sparkfun/SparkFun_Digi_XBee_Arduino_Shield-USB-C/docs/README.md

SparkFun Digi XBee® Development Arduino Shield (Qwiic)
========================================

SparkFun Digi XBee® Development Arduino Shield (Qwiic) (https://www.sparkfun.com/products/22131)

[*SparkFun Digi XBee® Development Arduino Shield (Qwiic) (22131)*](https://www.sparkfun.com/products/22131)

The Sparkfun Digi XBee® Arduino Shield is your gateway to a world of wireless innovation on your favorite Arduino device. This shield integrates Digi's cutting-edge XBee 3 Low-Power LTE-M/NB-IoT and Digi XBee RR Pro modules (or any existing through-hole Digi XBee module) with your trusty Arduino, empowering you to build wireless projects that reach further and do more than ever. Whether you're a seasoned developer or a curious beginner, the SparkFun Digi XBee® Arduino Shield - USB-C (Qwiic) empowers you to bring your wildest IoT ideas to life.

It breaks out the functionality of your XBee module and adds the ability to connect to the cellular network and GNSS. This shield includes a USB-C connector, a Qwiic connector for all those lovely I<sup>2</sup>C sensors, as well as a Reset button and a user-defined D0 button, the ability to power your board from the R3/R4 board, and UART selection. 

Repository Contents
-------------------

* **/Documents** - Data sheets, additional product information
* **/Hardware** - Eagle design files (.brd, .sch)
* **/Production** - Production panel files (.brd)
* **/docs** - Files related to the hookup guide

Documentation
--------------
* **[Hookup Guide](http://docs.sparkfun.com/SparkFun_Digi_XBee3_Arduino_Shield)** - Basic hookup guide for the SparkFun Digi XBee® Development Arduino Shield (Qwiic).

License Information
-------------------

This product is _**open source**_! 

Please review the LICENSE.md file for license information. 

If you have any questions or concerns on licensing, please contact technical support on our [SparkFun forums](https://forum.sparkfun.com/viewforum.php?f=152).

Distributed as-is; no warranty is given.

- Your friends at SparkFun.

_<COLLABORATION CREDIT>_
