sparkfun/SparkFun_Digi_XBee_Arduino_Shield-USB-C/docs/introduction.md

---
icon: material/book-open-page-variant
---

<div class="grid cards desc" markdown>

-    <a href="https://www.sparkfun.com/products/22131">
    **SparkFun Digi XBee® Development Arduino Shield (Qwiic)**<br>
    **SKU:** WRL-22131

    ---

    <figure markdown>
    Product Thumbnail
    </figure></a>
    
-    The Sparkfun Digi XBee® Arduino Shield is your gateway to a world of wireless innovation on your favorite Arduino device. This shield integrates Digi's cutting-edge XBee 3 Low-Power LTE-M/NB-IoT and Digi XBee RR Pro modules (or any existing through-hole Digi XBee module) with your trusty Arduino, empowering you to build wireless projects that reach further and do more than ever. Whether you're a seasoned developer or a curious beginner, the SparkFun Digi XBee® Arduino Shield - USB-C (Qwiic) empowers you to bring your wildest IoT ideas to life. It breaks out the functionality of your XBee module and adds the ability to connect to the cellular network and GNSS. This shield includes a USB-C connector, a Qwiic connector for all those lovely I<sup>2</sup>C sensors, as well as a Reset button and a user-defined D0 button, the ability to power your board from the R3/R4 board, and UART selection. 

    <center>
    [Purchase from SparkFun :fontawesome-solid-cart-plus:{ .heart }](https://www.sparkfun.com/products/22131){ .md-button .md-button--primary }
    </center>

</div>

## Required Materials
To get started, users will need a few items. Now some users may already have a few of these items, feel free to modify your cart accordingly.

<div class="grid cards" markdown>

-   <a href="https://www.sparkfun.com/products/22131">
    <figure markdown>
    Product Thumbnail
    </figure>

    ---

    **SparkFun Digi XBee® Development Arduino Shield (Qwiic)**<br>
    WRL-22131</a>

-   <a href="https://www.sparkfun.com/products/22329">
    <figure markdown>
    Product Thumbnail
    </figure>

    ---

    **Digi XBee 3 Low-Power LTE-M/NB-IoT, GNSS, no SIM**<br>
    WRL-22329</a>

-   <a href="https://www.sparkfun.com/products/14743">
    <figure markdown>
    Product Thumbnail
    </figure>

    ---

    **USB 3.1 Cable A to C - 3 Foot**<br>
    CAB-14743</a>

</div>

## Suggested Reading

As a more professionally oriented product, we will skip over the more fundamental tutorials (i.e. [**Ohm's Law**](https://learn.sparkfun.com/tutorials/voltage-current-resistance-and-ohms-law) and [**What is Electricity?**](https://learn.sparkfun.com/tutorials/what-is-electricity)). However, below are a few tutorials that may help users familiarize themselves with various aspects of the board.

<div class="grid cards hide col-4" markdown align="center">

-   <a href="https://learn.sparkfun.com/tutorials/how-to-solder-through-hole-soldering">
    <figure markdown>
    How to Solder: Through-Hole Soldering
    </figure>
    </a>
    <a href="https://learn.sparkfun.com/tutorials/how-to-solder-through-hole-soldering">**How to Solder: Through-Hole Soldering**
    </a>

-   <a href="https://learn.sparkfun.com/tutorials/sparkfun-serial-basic-ch340c-hookup-guide">
    <figure markdown>
    SparkFun Serial Basic CH340C Hookup Guide
    </figure>
    </a>
    <a href="https://learn.sparkfun.com/tutorials/sparkfun-serial-basic-ch340c-hookup-guide">**SparkFun Serial Basic CH340C Hookup Guide**
    </a>    

-   <a href="https://learn.sparkfun.com/tutorials/82">
    <figure markdown>
    I2C
    </figure>
    </a>
    <a href="https://learn.sparkfun.com/tutorials/82">**I2C**
    </a>

-   <a href="https://learn.sparkfun.com/tutorials/analog-vs-digital">
    <figure markdown>
    Analog vs. Digital
    </figure>
    </a>
    <a href="https://learn.sparkfun.com/tutorials/analog-vs-digital">**Analog vs. Digital**
    </a>

-   <a href="https://learn.sparkfun.com/tutorials/serial-peripheral-interface-spi">
    <figure markdown>
    SPI
    </figure>
    </a>
    <a href="https://learn.sparkfun.com/tutorials/serial-peripheral-interface-spi">**SPI**
    </a>
</div>

<center>
<div align="center">
    <div style="top:5px;left:5px;background-color:Gray;position:relative">
        <div style="top:-5px;left:-5px;background-color:#ffffff;position:relative;border:1px solid black;">
            <a href="https://www.sparkfun.com/qwiic">Qwiic Connect System</a>
        </div>
    </div>
</div>
</center>

The Sparkfun Digi XBee® Arduino Shield takes advantage of the [Qwiic connect system](https://www.sparkfun.com/qwiic). We recommend familiarizing yourself with the **Logic Levels** and **I<sup>2</sup>C** tutorials.  Click on the banner above to learn more about [Qwiic products](https://www.sparkfun.com/qwiic).

<center>
    <iframe width="600" height="327" src="https://www.youtube.com/embed/x0RDEHqFIF8" title="SparkFun's Qwiic Connect System" frameborder="0" allow="accelerometer; autoplay; clipboard-write; encrypted-media; gyroscope; picture-in-picture" allowfullscreen></iframe>
</center>
