sparkfun/SparkFun_Digi_XBee_Arduino_Shield-USB-C/docs/resources_and_going_further.md

For more information related to the SparkFun Digi XBee® Arduino Shield, check out the resources below:

* [Product Page](https://www.sparkfun.com/products/22131){ target="_blank" }
* [Schematic](assets/board_files/22131_SparkFun_Digi_XBee_Arduino_Shield_Qwiic_Schematic.pdf){ target="_blank" }
* [Eagle Files](assets/board_files/SparkFun_Digi_XBee_Arduino_Shield_Qwiic_EagleFiles.zip){ target="_blank" }
* [Board Dimensions](assets/board_files/22131_SparkFun_Digi_XBee_Arduino_Shield_Qwiic_BoardOutline.png){ target="_blank" }
* [Hardware GitHub Respository](https://github.com/sparkfun/SparkFun_Digi_XBee_Arduino_Shield-USB-C){ target="_blank" }
* [Digi XBee® 3 Cat1 Smart Modem User Guide](assets/BoardFiles/XBee3_LTE_Cat_1-UserGuide-90002503-1.pdf){ target="_blank" }

Or check out other [Digi XBee Projects](https://learn.sparkfun.com/tutorials/tags/xbee) for inspiration:

<table style="border-style:none">
    <tr>
        <td style="vertical-align: text-top;" width="264px">
            <a href="https://www.sparkfun.com/news/3252">
            
            <h3 style="vertical-align: left">Be All That You Can XBee
            </h3></a>
        </td>
        <td style="vertical-align: text-top;" width="264px">
            <div style="text-align: center"><a href="https://www.sparkfun.com/news/2891">
            </div>
            <h3 style="text-align: left">Wireless RC Robot with Arduino and XBees
            </h3></a>
        </td>
        <td style="vertical-align: text-top;" width="264px">
            <div style="text-align: center"><a href="https://www.sparkfun.com/news/2761">
            </div>
            <h3 style="text-align: left">Enginursday: Prototype Capacitive Touch Dance Floor with a Teensy and XBees
            </h3></a>
        </td>
        <td style="vertical-align: text-top;" width="264px">
            <a href="https://www.sparkfun.com/news/2911">
            
            <h3 style="text-align: left">Wireless Gesture-Controlled Robot
            </h3></a>
        </td>
    </tr>
</table>
