sparkfun/SparkFun_Digi_XBee_Arduino_Shield-USB-C/docs/single_page.md

---
hide:
  - navigation
  - toc
icon: fontawesome/solid/scroll
---

# Introduction
--8<-- "./docs/introduction.md:5"

# Hardware Overview
--8<-- "./docs/hardware_overview.md:5"

# Hardware Assembly
--8<-- "./docs/hardware_assembly.md:5"

## Software Setup
--8<-- "./docs/software_setup_and_programming.md:5"

# Troubleshooting Tips
--8<-- "./docs/troubleshooting.md:5"

# Resources:
--8<-- "./docs/resources_and_going_further.md:5"
