sparkfun/SparkFun_Digi_XBee_Arduino_Shield-USB-C/docs/assets/img/22131-XBee_Dev_Arduino_Shield-USBCConnex.jpg

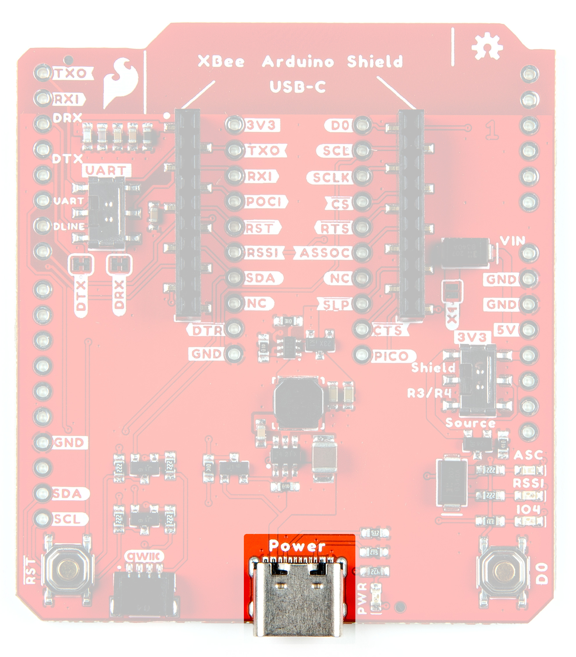
docs/assets/img/22131-XBee_Dev_Arduino_Shield-USBCConnex.jpg
