sparkfun/SparkFun_Digi_XBee_Arduino_Shield-USB-C/docs/hardware_assembly.md

---
icon: fontawesome/solid/screwdriver-wrench
---

Note the white silkscreen on the Shield PCB - this will help orient your Digi XBee as you're plugging it in. Make sure to match up the Digi XBee's two diagonal edges with the two diagonal lines on the PCB.

<figure markdown>
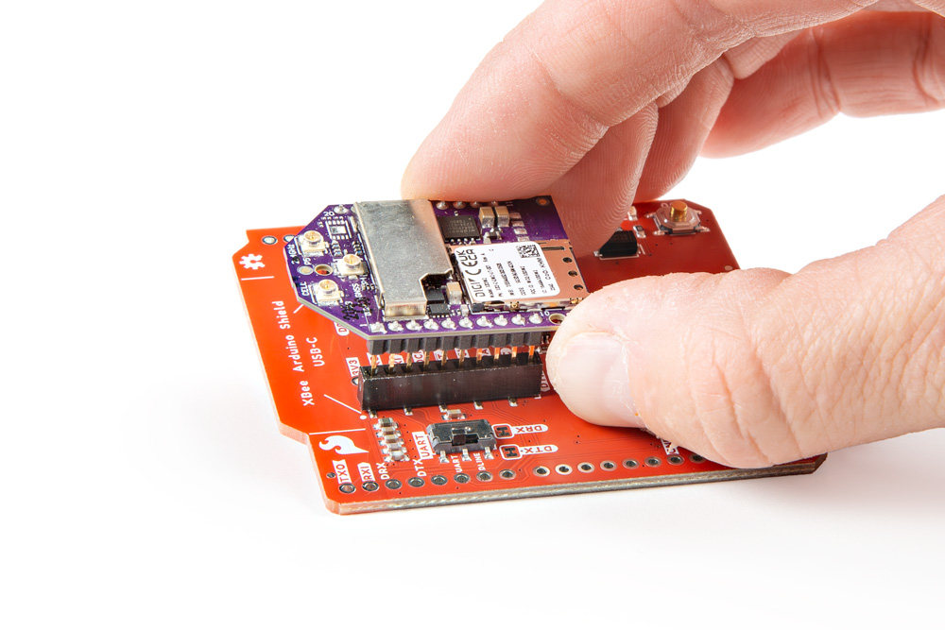
[picture p17: docs/assets/img/22131-Action-1.jpg]
Fitting the XBee into the Arduino Shield's Socket

<figcaption markdown>Fitting the Digi XBee into the Arduino Shield's Socket</figcaption>
</figure>
