sparkfun/SparkFun_Digi_XBee_Arduino_Shield-USB-C/Production/ordering_instructions.txt

panel size, 121x204mm
PCB thickness, 1.6mm
number of layers, 4
controlled impedance, JLC7628
soldermask color, Red
silkscreen color, White
oz copper, 1oz
finish, HASL lead free
stencils, top
pcs per panel, 6
min trace width, 0.2032mm / 0.0080in
min drill size, 0.3048mm / 0.0120in
filename to layer stackup 1/2/3/4: GTL, GL2, GL3, GBL
