sparkfun/SparkFun_Digi_XBee_Arduino_Shield-USB-C/docs/software_setup_and_programming.md

We have a number of tutorials detailing how to work with Digi XBees and their associated software. In particular, [XCTU](https://www.digi.com/products/embedded-systems/digi-xbee/digi-xbee-tools/xctu) is free software provided by Digi (the manufacturer of XBee), that provides a quick and easy way to configure and manage Digi XBees as well as test Digi XBee networks. 

If you haven't worked with XCTU before, head on over to our [Exploring XBees and XCTU tutorial](https://learn.sparkfun.com/tutorials/exploring-xbees-and-xctu/all#starting-with-x-ctu) to get set up.  

<center><table class="tg">
  <tr>
    <th class="tg-v0mg"><a href="https://learn.sparkfun.com/tutorials/exploring-xbees-and-xctu/all#starting-with-x-ctu">Exploring XBees and XCTU tutorial</a></th>
  </tr>
  <tr>
    <td class="tg-v0mg"><i>Exploring Digi XBees and XCTU tutorial</i></td>
  </tr>
</table>
</center>

You might also check out this [Digi XBee WiFi Hookup Guide](https://learn.sparkfun.com/tutorials/xbee-wifi-hookup-guide) if your project includes WiFi! 

<center>
<table class="tg">
  <tr>
    <th class="tg-v0mg"><a href="https://learn.sparkfun.com/tutorials/xbee-wifi-hookup-guide">XBee WiFi Hookup Guide</a></th>
  </tr>
  <tr>
    <td class="tg-v0mg"><i>XBee WiFi Hookup Guide</i></td>
  </tr>
</table>
</center>
