sparkfun/SparkFun_Digi_XBee_Arduino_Shield-USB-C/docs/troubleshooting.md

---
icon: fontawesome/solid/question
---

!!! note
    <span class="glyphicon glyphicon-question-sign" aria-hidden="true"></span>
        <strong> Not working as expected and need help? </strong> <br /><br />

    If you need technical assistance and more information on a product that is not working as you expected, we recommend heading on over to the <a href="https://www.sparkfun.com/technical_assistance">SparkFun Technical Assistance</a> page for some initial troubleshooting. <br /><br />

    <div style="text-align: center"><a href="https://www.sparkfun.com/technical_assistance" target="sfe_technical_assistance" class="md-button">SparkFun Technical Assistance Page</a></div>

    If you don't find what you need there, the <a href="https://forum.sparkfun.com/index.php">SparkFun Forums</a> are a great place to find and ask for help. If this is your first visit, you'll need to <a href="https://forum.sparkfun.com/ucp.php?mode=register">create a Forum Account</a> to search product forums and post questions.<br /><br />

    <div style="text-align: center"><a href="https://forum.sparkfun.com/ucp.php?mode=register" class="md-button">Create New Forum Account</a>&nbsp;&nbsp;&nbsp;<a href="https://forum.sparkfun.com/index.php" class="md-button md-button--primary">Log Into SparkFun Forums</a></div>
