sparkfun/SparkFun_Digi_XBee_Arduino_Shield-USB-C/docs/assets/board_files/22131_SparkFun_Digi_XBee_Arduino_Shield_Qwiic_Schematic.pdf

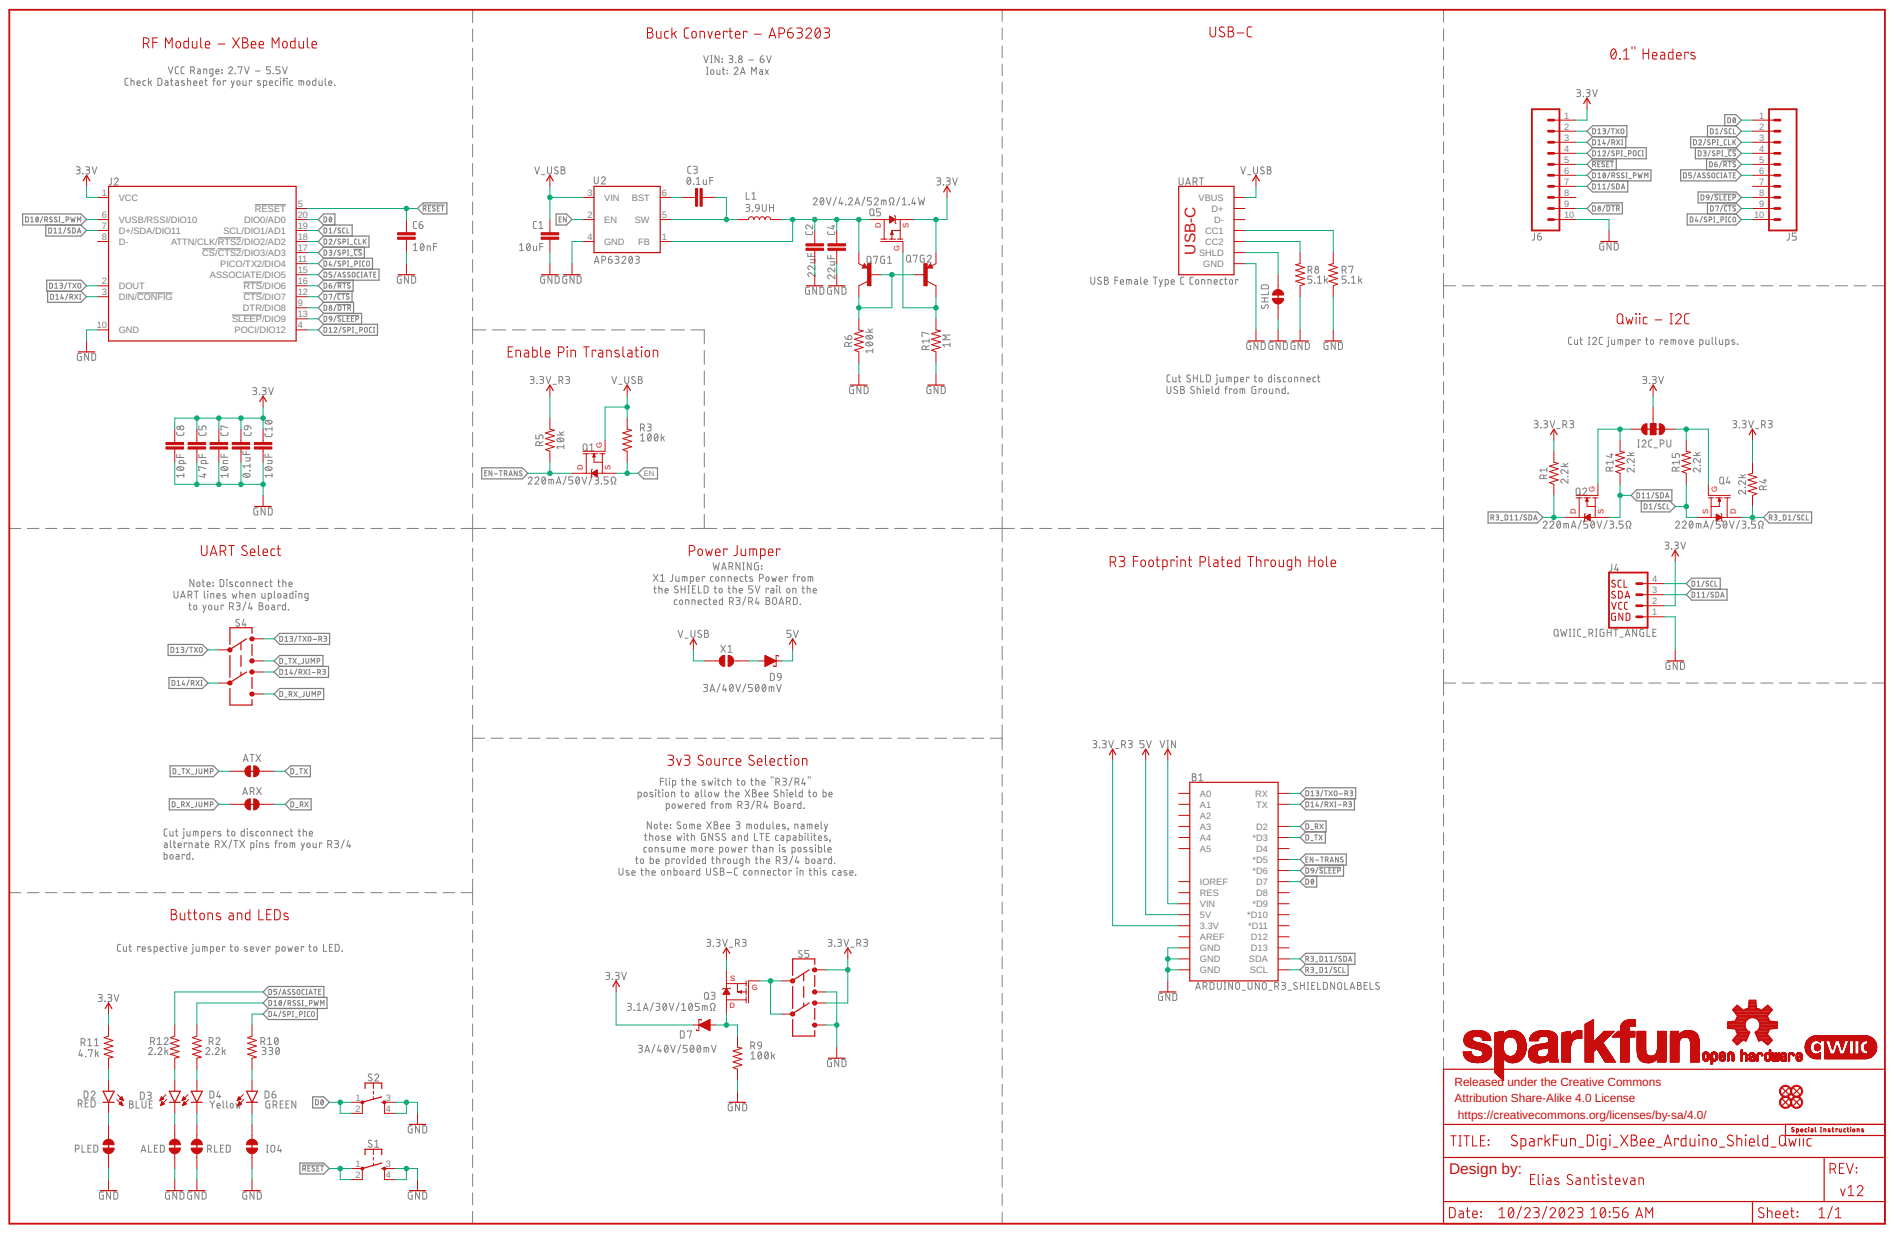
[picture p18: page 1]
