sparkfun/SparkFun_Digi_XBee_Arduino_Shield-USB-C/Hardware/SparkFun_Digi_XBee_Arduino_Shield_Qwiic.brd

## EAGLE design Hardware/SparkFun_Digi_XBee_Arduino_Shield_Qwiic.brd (2023-10-13)

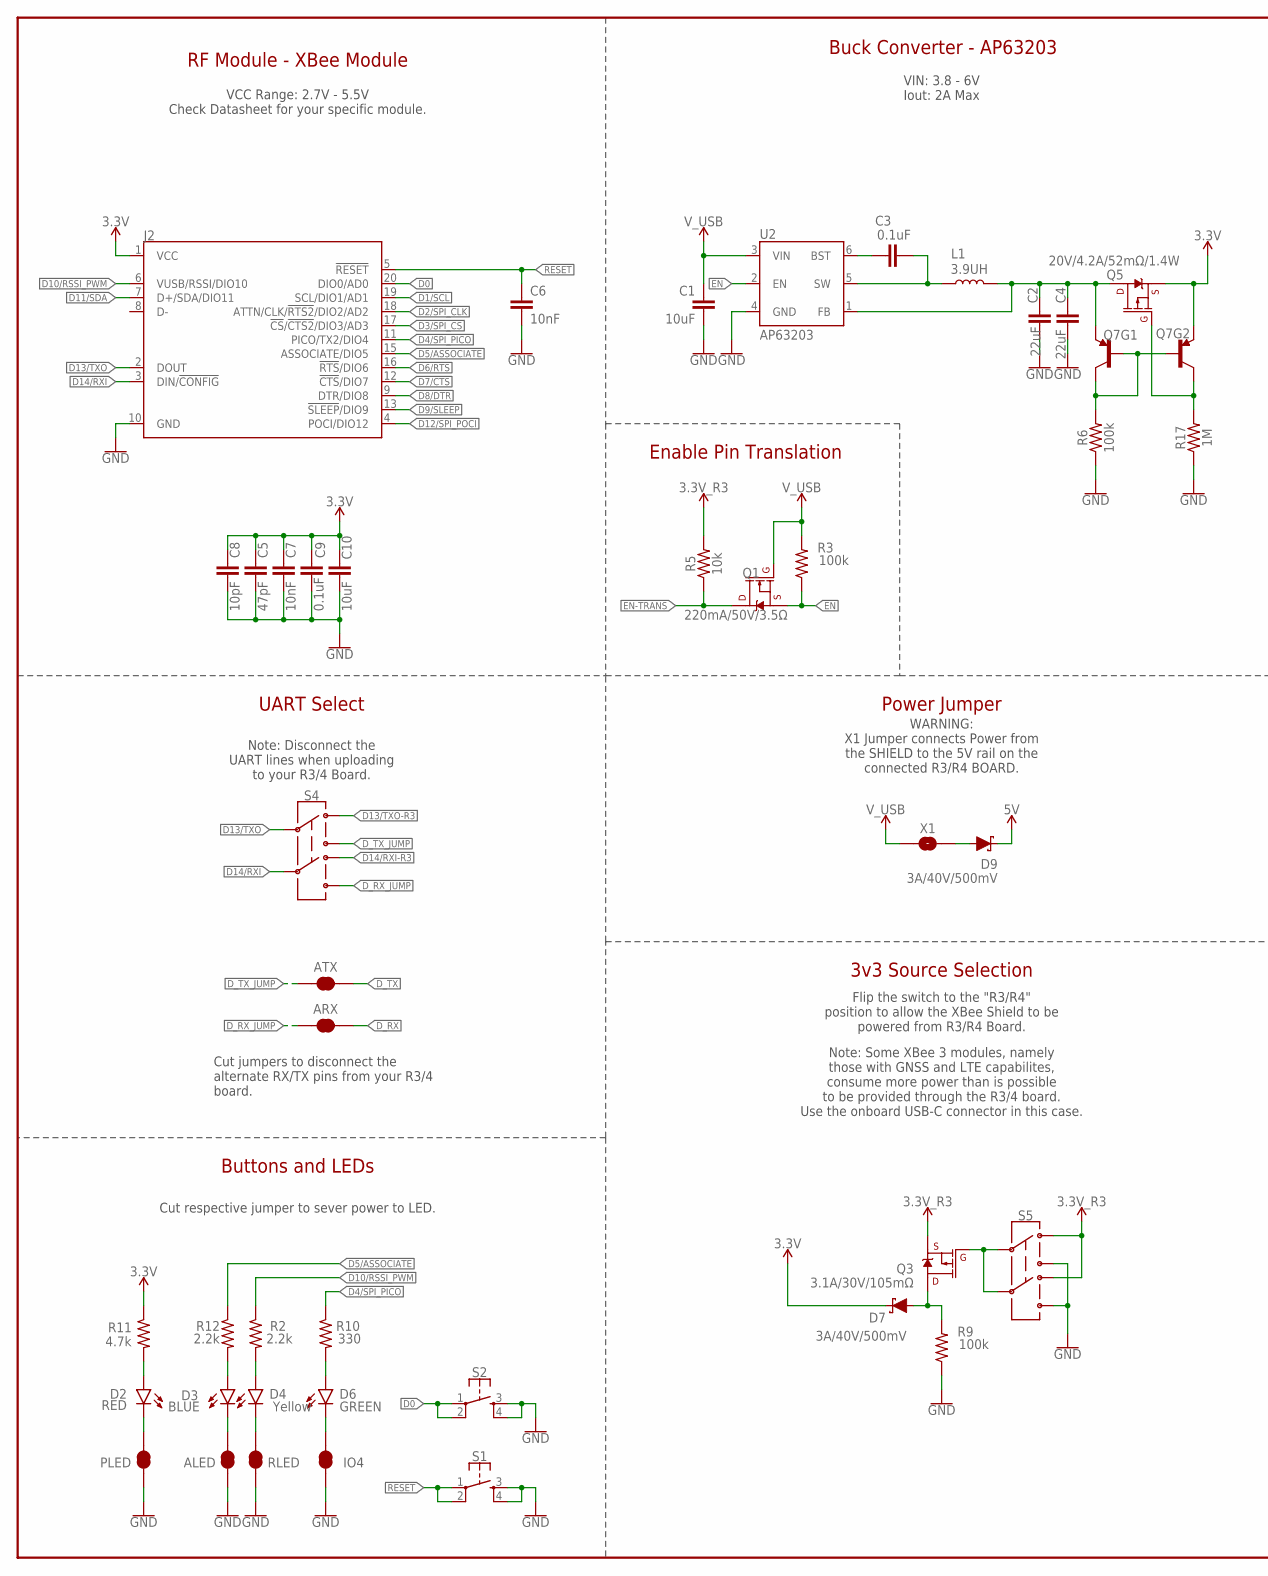
[picture p19: schematic SparkFun_Digi_XBee_Arduino_Shield_Qwiic.sch, part in row 1, column 1]

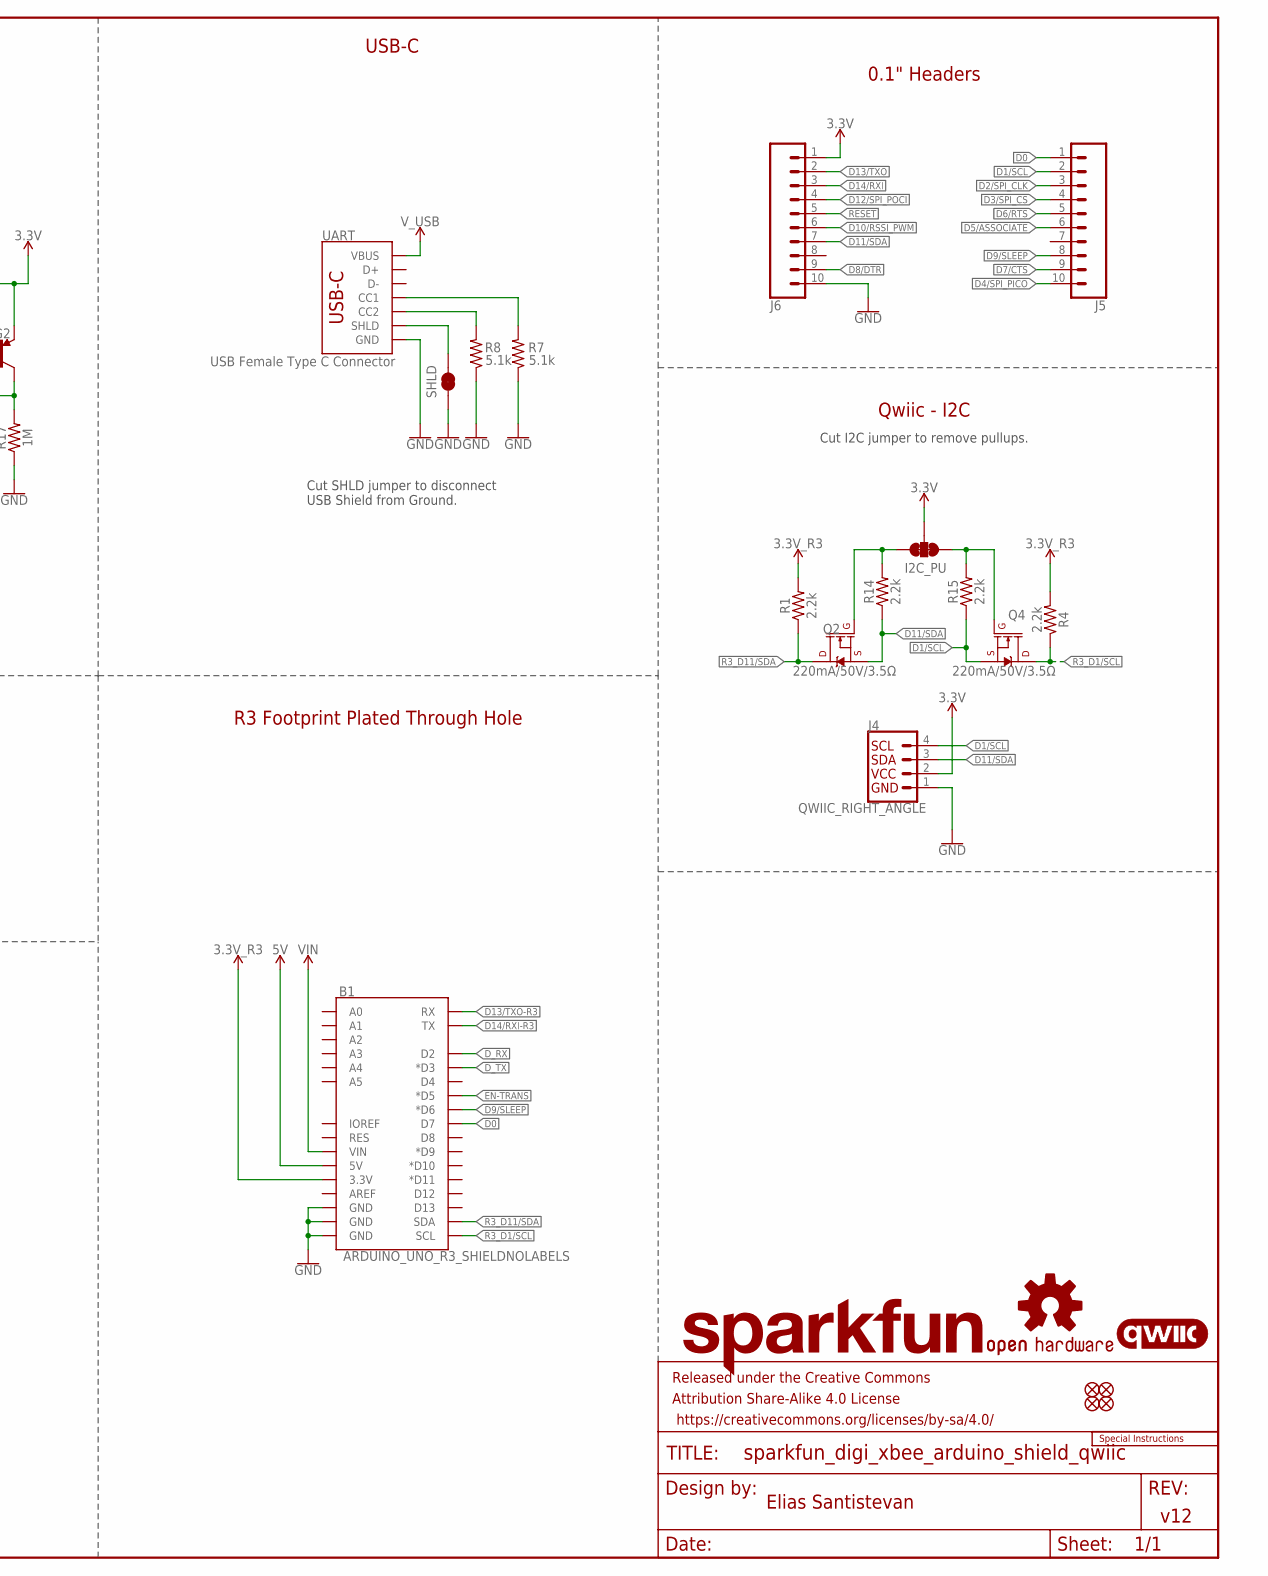
[picture p20: schematic SparkFun_Digi_XBee_Arduino_Shield_Qwiic.sch, part in row 1, column 2]

Parts:
ALED: JUMPER-SMT_2_NC_TRACE_SILK; SMT-JUMPER_2_NC_TRACE_SILK
ARX: JUMPER-SMT_2_NC_TRACE_SILK; SMT-JUMPER_2_NC_TRACE_SILK
ATX: JUMPER-SMT_2_NC_TRACE_SILK; SMT-JUMPER_2_NC_TRACE_SILK
B1: ARDUINO_UNO_R3_SHIELDNOLABELS; UNO_R3_SHIELD_NOLABELS
C1: 10uF; 1210
C2, C4: 22uF; 0603
C3, C9: 0.1uF; 0603
C5: 47pF; 0603
C6, C7: 10nF; 0603
C8: 10pF; 0603
C10: 10uF; 0603
D2: RED; LED-0603
D3: BLUE; LED-0603
D4: Yellow; LED-0603
D6: GREEN; LED-0603
D7, D9: 3A/40V/500mV; SMA-DIODE
FD1, FD2, FD3, FD4: FIDUCIAL1X2; FIDUCIAL-1X2
FRAME1: FRAME-LEDGER; CREATIVE_COMMONS
I2C_PU: JUMPER-SMT_3_2-NC_TRACE_SILK; SMT-JUMPER_3_2-NC_TRACE_SILK
IO4: JUMPER-SMT_2_NC_TRACE_SILK; SMT-JUMPER_2_NC_TRACE_SILK
J2: XBEE_UPDATEXBEE_SMD; XBEE3-SMD
J4: QWIIC_RIGHT_ANGLE; JST04_1MM_RA
J5, J6: CONN_10NO_SILK_PTH_FEMALE; 1X10_NO_SILK
L1: 3.9UH; INDUCTOR_3.9UH
LOGO1: SFE_LOGO_NAMEBLANK; BLANK
LOGO2: OSHW-LOGOS; OSHW-LOGO-S
LOGO3: QWIIC_LOGO_4MM; QWIIC_4MM
LOGO4: SPECIAL_INSTRUCTIONS-ORDERING; ORDERING_INSTRUCTIONS
PLED: JUMPER-SMT_2_NC_TRACE_SILK; SMT-JUMPER_2_NC_TRACE_SILK
Q1, Q2, Q4: 220mA/50V/3.5Ω; SOT23-3
Q3: 3.1A/30V/105mΩ; SOT23-3
Q5: 20V/4.2A/52mΩ/1.4W; SOT23-3
Q7: TRANS_PNP_DUALSOT-363; SOT363_PHILIPS
R1, R2, R4, R12, R14, R15: 2.2k; 0603
R3, R6, R9: 100k; 0603
R5: 10k; 0603
R7, R8: 5.1k; 0603
R10: 330; 0603
R11: 4.7k; 0603
R17: 1M; 0603
RLED: JUMPER-SMT_2_NC_TRACE_SILK; SMT-JUMPER_2_NC_TRACE_SILK
S1, S2: MOMENTARY-SWITCH-SPST-2-SMD-5.2MM-TALL; TACTILE_SWITCH_SMD_5.2MM
S4, S5: SWITCH-DPDT-SMD-AYZ0202; SWITCH_DPDT_SMD_AYZ0202
SHLD: JUMPER-SMT_2_NC_TRACE_SILK; SMT-JUMPER_2_NC_TRACE_SILK
U2: AP63203; SOT23-6
UART: USB Female Type C Connector; USB-C-16P-4LAYER-ISOLATED
X1: JUMPER-SMT_2_NO_SILK; SMT-JUMPER_2_NO_SILK

Connections:
3.3V: C5.1, C7.1, C8.1, C9.1, C10.1, D7.C, I2C_PU.2, J2.1 (VCC), J4.2, J6.1, Q5.2 (S), Q7.4 (E), R11.1
3.3V_R3: B1.3.3V, Q3.2 (S), R1.2, R4.2, R5.2, S5.3, S5.6
3.3V_VREG: C2.1, C4.1, L1.P$2 (2), Q5.3 (D), Q7.1 (E), U2.1 (FB)
5V: B1.5V, D9.C
!RESET!: C6.1, J2.5 (!RESET!), J6.5, S1.1, S1.2
D0: B1.D7, J2.20 (DIO0/AD0), J5.1, S2.1, S2.2
D1/SCL: J2.19 (SCL/DIO1/AD1), J4.4, J5.2, Q4.2 (S), R15.1
D2/SPI_CLK: J2.18 (ATTN/CLK/!RTS2!/DIO2/AD2), J5.3
D3/SPI_!CS!: J2.17 (!CS!/!CTS2!/DIO3/AD3), J5.4
D4/SPI_PICO: J2.11 (PICO/TX2/DIO4), J5.10, R10.1
D5/ASSOCIATE: J2.15 (ASSOCIATE/DIO5), J5.6, R12.1
D6/!RTS!: J2.16 (!RTS!/DIO6), J5.5
D7/!CTS!: J2.12 (!CTS!/DIO7), J5.9
D8/!DTR!: J2.9 (DTR/DIO8), J6.9
D9/!SLEEP!: B1.D6 (*D6), J2.13 (!SLEEP!/DIO9), J5.8
D10/RSSI_PWM: J2.6 (VUSB/RSSI/DIO10), J6.6, R2.1
D11/SDA: J2.7 (D+/SDA/DIO11), J4.3, J6.7, Q2.2 (S), R14.1
D12/SPI_POCI: J2.4 (POCI/DIO12), J6.4
D13/TXO: J2.2 (DOUT), J6.2, S4.2
D13/TXO-R3: B1.RX, S4.3
D14/RXI: J2.3 (DIN/!CONFIG!), J6.3, S4.5
D14/RXI-R3: B1.TX, S4.6
D_RX: ARX.2, B1.D2
D_RX_JUMP: ARX.1, S4.4
D_TX: ATX.2, B1.D3 (*D3)
D_TX_JUMP: ATX.1, S4.1
EN: Q1.2 (S), R3.1, U2.2 (EN)
EN-TRANS: B1.D5 (*D5), Q1.3 (D), R5.1
GND: ALED.1, B1.GND@0 (GND), B1.GND@1 (GND), B1.GND@2 (GND), C1.2, C2.2, C4.2, C5.2, C6.2, C7.2, C8.2, C9.2, C10.2, IO4.1, J2.10 (GND), J4.1, J6.10, PLED.1, R6.1, R7.1, R8.1, R9.1, R17.1, RLED.1, S1.3, S1.4, S2.3, S2.4, S5.1, S5.4, SHLD.1, U2.4 (GND), UART.GND, UART.GND2 (GND)
unnamed: C3.1, U2.6 (BST)
unnamed: D4.A, R2.2
unnamed: D4.C, RLED.2
unnamed: D6.A, R10.2
unnamed: R8.2, UART.B5 (CC2)
unnamed: R7.2, UART.A5 (CC1)
unnamed: D2.A, R11.2
unnamed: C3.2, L1.P$1 (1), U2.5 (SW)
unnamed: D9.A, X1.2
unnamed: I2C_PU.1, Q4.1 (G), R15.2
unnamed: I2C_PU.3, Q2.1 (G), R14.2
unnamed: D3.A, R12.2
unnamed: D7.A, Q3.3 (D), R9.2
unnamed: D6.C, IO4.2
unnamed: Q7.2 (B), Q7.5 (B), Q7.6 (C), R6.2
unnamed: Q5.1 (G), Q7.3 (C), R17.2
unnamed: ALED.2, D3.C
unnamed: D2.C, PLED.2
unnamed: Q3.1 (G), S5.2, S5.5
R3_D1/SCL: B1.SCL, Q4.3 (D), R4.1
R3_D11/SDA: B1.SDA, Q2.3 (D), R1.1
SHLD: SHLD.2, UART.SHLD1 (SHLD), UART.SHLD2 (SHLD), UART.SHLD3 (SHLD), UART.SHLD4 (SHLD), UART.SHLD5 (SHLD), UART.SHLD6 (SHLD), UART.SHLD7 (SHLD), UART.SHLD8 (SHLD)
VIN: B1.VIN
V_USB: C1.1, Q1.1 (G), R3.2, U2.3 (VIN), UART.VBUS1 (VBUS), UART.VBUS2 (VBUS), X1.1

Notes on the sheet:
VCC Range: 2.7V - 5.5V Check Datasheet for your specific module.
Buck Converter - AP63203
Qwiic - I2C
v12
Elias Santistevan
Buttons and LEDs
VIN: 3.8 - 6V Iout: 2A Max
Cut I2C jumper to remove pullups.
Cut respective jumper to sever power to LED.
RF Module - XBee Module
0.1" Headers
Cut SHLD jumper to disconnect USB Shield from Ground.
USB-C
R3 Footprint Plated Through Hole
Power Jumper
Enable Pin Translation
3v3 Source Selection
WARNING: X1 Jumper connects Power from the SHIELD to the 5V rail on the connected R3/R4 BOARD.
Flip the switch to the "R3/R4" position to allow the XBee Shield to be powered from R3/R4 Board.
Note: Some XBee 3 modules, namely those with GNSS and LTE capabilites, consume more power than is possible to be provided through the R3/4 board. Use the onboard USB-C connector in this case.
UART Select
Note: Disconnect the UART lines when uploading to your R3/4 Board.
Cut jumpers to disconnect the alternate RX/TX pins from your R3/4 board.

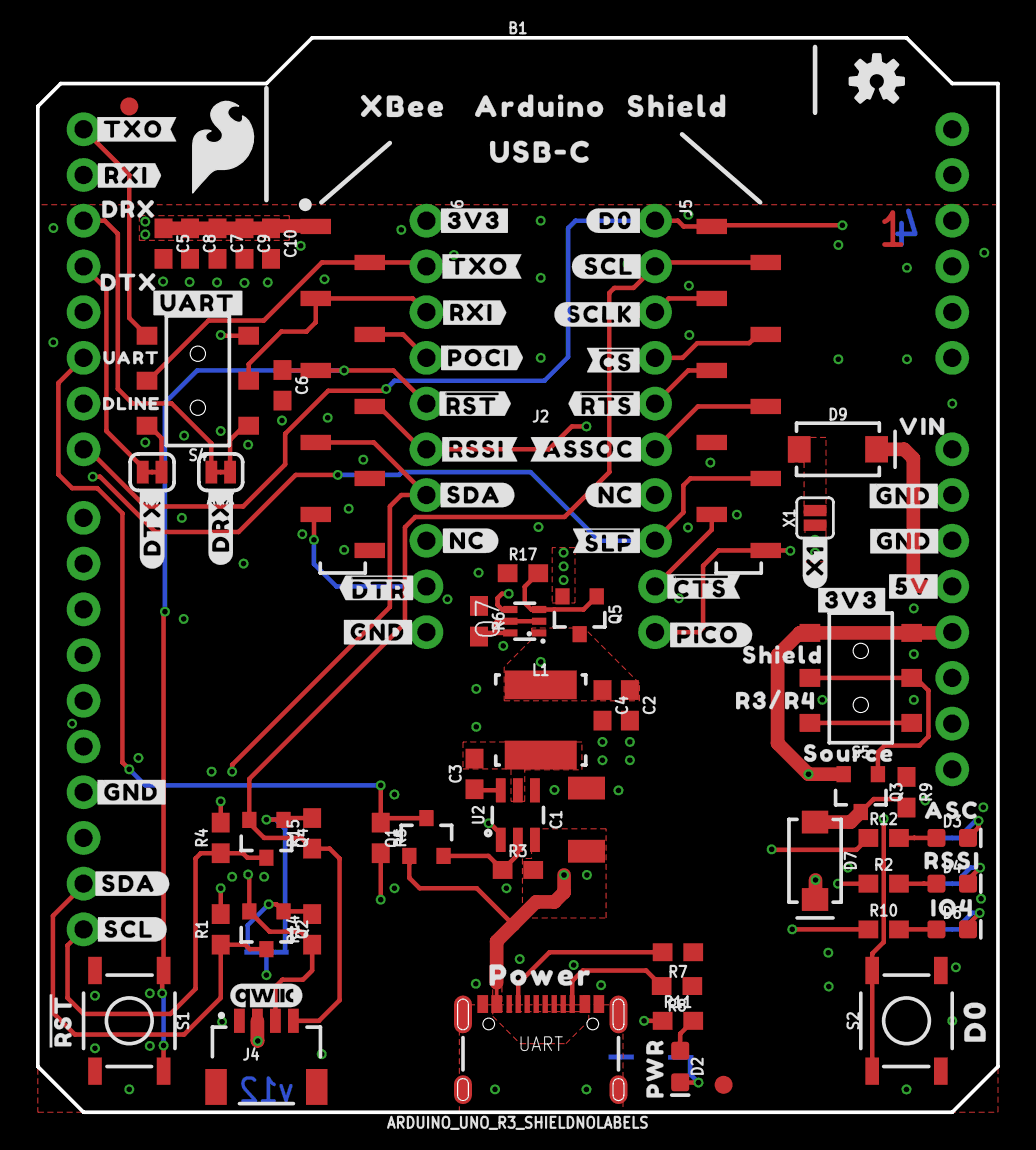
[picture p21: board SparkFun_Digi_XBee_Arduino_Shield_Qwiic.brd from above]

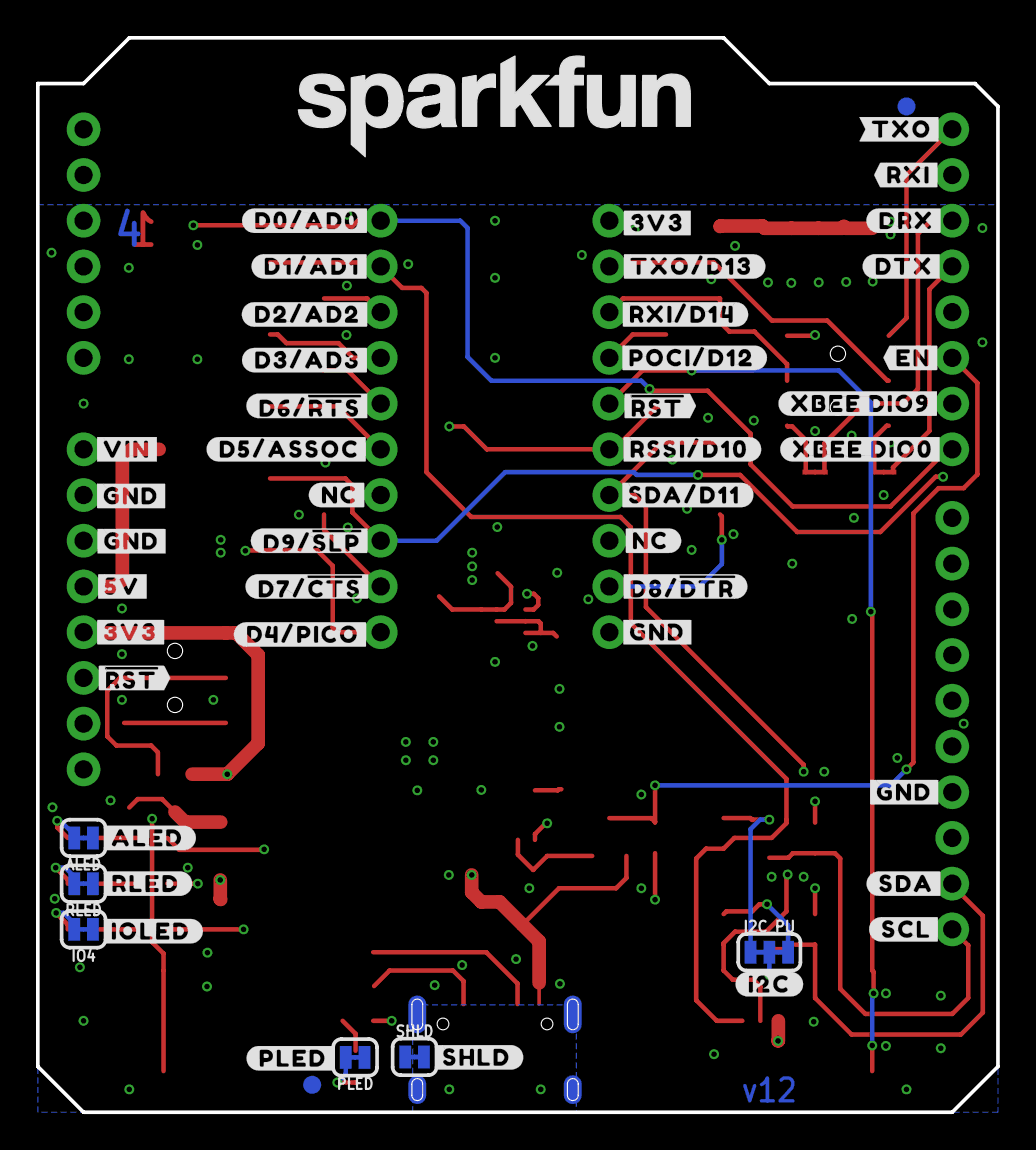
[picture p22: board SparkFun_Digi_XBee_Arduino_Shield_Qwiic.brd from below]

Board: 4 copper layers, 53.3 x 59.7 mm, 163 parts (51 on the bottom side), 52 nets.

Other parts of the board:
U$1: RSSI31
U$2: PWR29
U$3, U$56: #SDA#10
U$4: #SHLD#36
U$5, U$9: #NC#1
U$6: #D3#AD3#23
U$7, U$10: #NC#3
U$8: ##DTR##27
U$11: #D1#AD1#8
U$12: ##CTS##28
U$13: #D8##DTR##27
U$14: #RSSI#D10#17
U$15: #SDA#D11#9
U$16: ##RST##15
U$17: #POCI#D12#24
U$18: #RXI#D14#15
U$19: #D2#AD2#19
U$20: #D6##RTS##25
U$21, U$32: #TXO#8
U$22: #TXO#D13#13
U$23: VIN5
U$24: #SCL#7
U$25, U$29, U$41, U$50, U$53, U$63, U$76, U$82: #GND#0
U$26: #I2C#33
U$27, U$33: #RXI#7
U$28: DRX52
U$30: #RST#30
U$31: #PICO#27
U$34: DTX53
U$35: #D5#ASSOC#25
U$36: #D9##SLP##28
U$37: #D7##CTS##26
U$38: #D4#PICO#25
U$39, U$66: #5V#5
U$40: D03
U$42: DLINE45
U$43: #X1#10
U$44, U$47, U$77, U$84: #3V3#1
U$45: #POCI#32
U$46: SHIELD55
U$48: UART44
U$49: #ALED#21
U$51: #RLED#22
U$52: #PLED#20
U$54, U$87: ##RST##13
U$55: #RSSI#16
U$57: #ASSOC#28
U$58: ##RTS##14
U$59: ##CS##26
U$60: #SCLK#33
U$61: SFE_LOGO_FLAME_.2
U$62: SFE_LOGO_NAME_.2
U$64: #SCL#9
U$65: #D0#3
U$67: #SDA#9
U$68: ##SLP##28
U$69: R3#R455
U$70: #SCL#13
U$71, U$86: #DRX#56
U$72, U$89: #DTX#57
U$73: #TXO#61
U$74: ASC32
U$75: POWER49
U$78: #D0#AD0#18
U$79: ARDUINO1345
U$80: XBEE340
U$81: SHIELD1346
U$83: #EN#15
U$85: #RXI#60
U$88: #VIN#4
U$90: #XBEE_DIO0#62
U$91: #UART#4048234
U$92: #XBEE_DIO9#62
U$93: #IOLED#5
U$94: IO49
U$95: SOURCE54
U$96: USB#C58
