sparkfun/SparkFun_Digi_XBee_Arduino_Shield-USB-C/Production/SparkFun_XBee_Arduino_Shield_Qwiic-Panel.brd

## EAGLE design Production/SparkFun_XBee_Arduino_Shield_Qwiic-Panel.brd (2023-10-13)

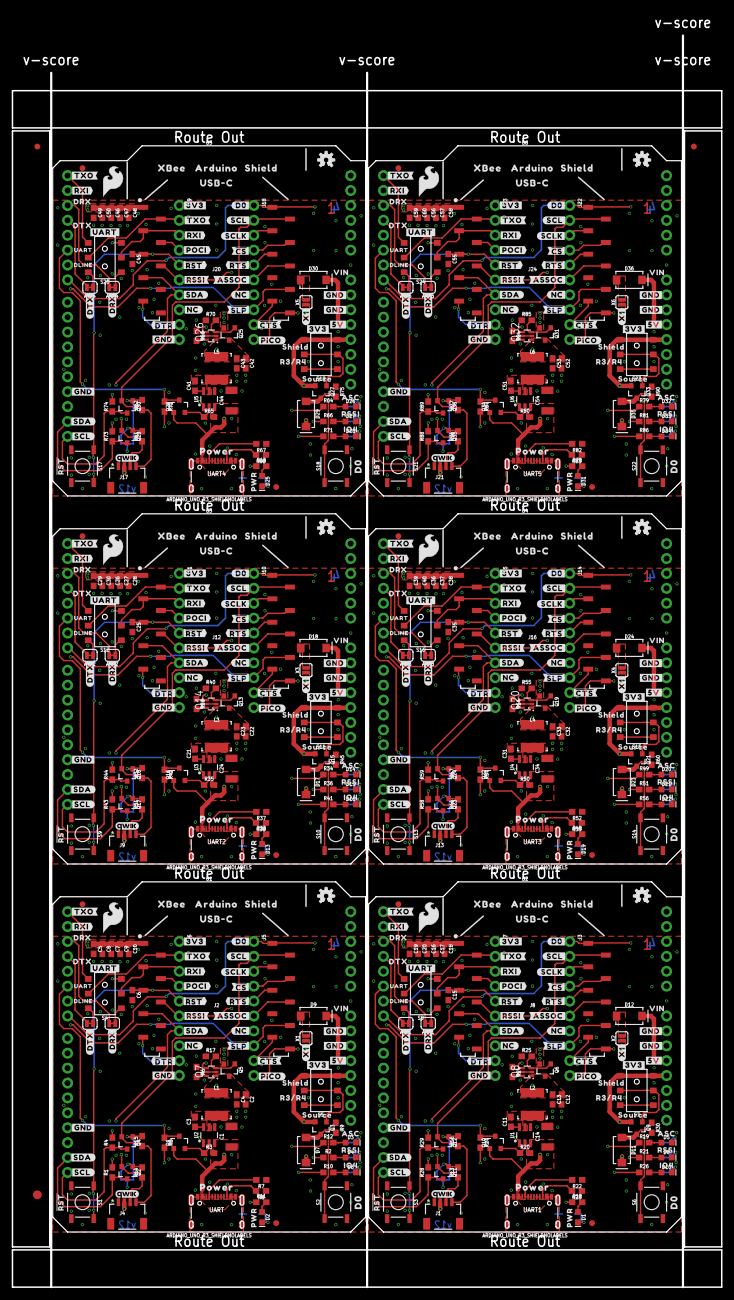
[picture p23: board SparkFun_XBee_Arduino_Shield_Qwiic-Panel.brd from above]

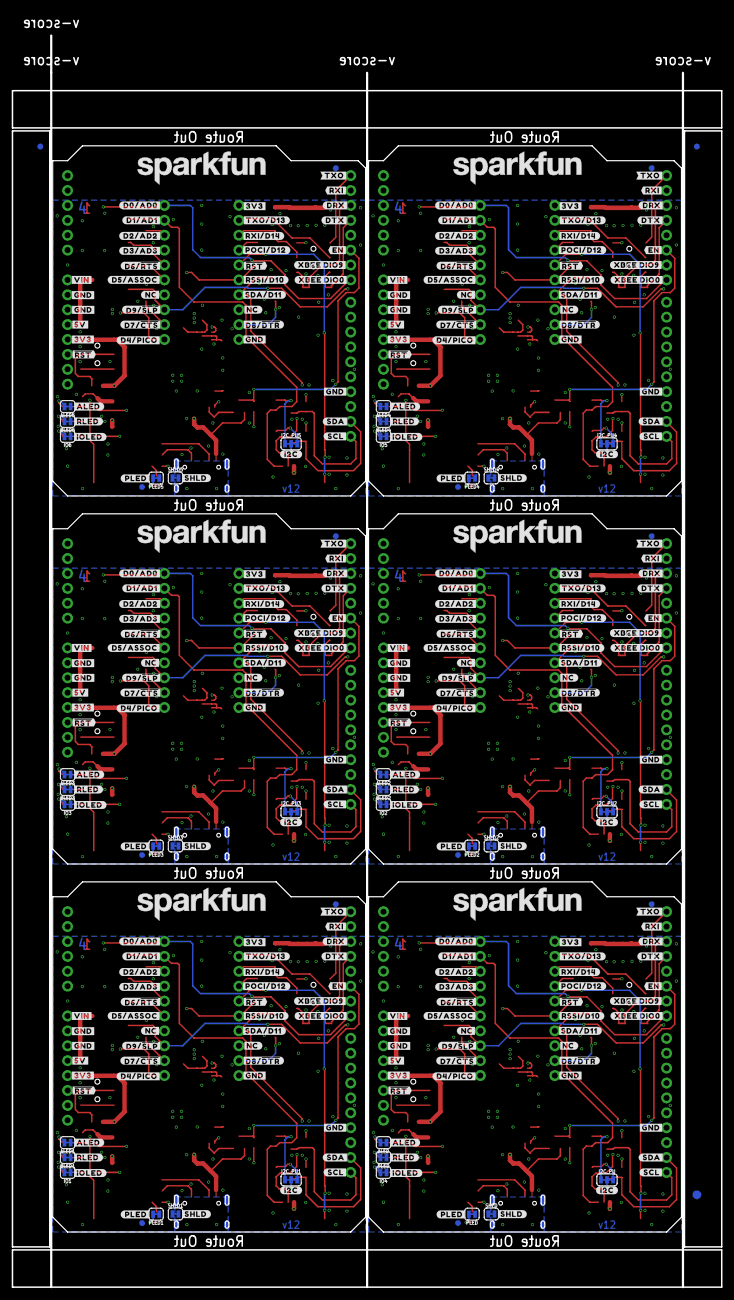
[picture p24: board SparkFun_XBee_Arduino_Shield_Qwiic-Panel.brd from below]

Board: 4 copper layers, 120.9 x 213.4 mm, 972 parts (309 on the bottom side), 312 nets.

Parts:
ALED, ALED1, ALED2, ALED3, ALED4, ALED5: JUMPER-SMT_2_NC_TRACE_SILK; SMT-JUMPER_2_NC_TRACE_SILK
ARX, ARX1, ARX2, ARX3, ARX4, ARX5: JUMPER-SMT_2_NC_TRACE_SILK; SMT-JUMPER_2_NC_TRACE_SILK
ATX, ATX1, ATX2, ATX3, ATX4, ATX5: JUMPER-SMT_2_NC_TRACE_SILK; SMT-JUMPER_2_NC_TRACE_SILK
B1, B2, B3, B4, B5, B6: ARDUINO_UNO_R3_SHIELDNOLABELS; UNO_R3_SHIELD_NOLABELS
C1, C14, C24, C34, C44, C54: 10uF; 1210
C2, C4, C12, C13, C22, C23, C32, C33, C42, C43, C52, C53: 22uF; 0603
C3, C9, C11, C17, C21, C27, C31, C37, C41, C47, C51, C57: 0.1uF; 0603
C5, C19, C29, C39, C49, C59: 47pF; 0603
C6, C7, C15, C16, C25, C26, C35, C36, C45, C46, C55, C56: 10nF; 0603
C8, C20, C30, C40, C50, C60: 10pF; 0603
C10, C18, C28, C38, C48, C58: 10uF; 0603
D1, D2, D13, D19, D25, D31: RED; LED-0603
D3, D5, D14, D20, D26, D32: BLUE; LED-0603
D4, D8, D15, D21, D27, D33: Yellow; LED-0603
D6, D10, D16, D22, D28, D34: GREEN; LED-0603
D7, D9, D11, D12, D17, D18, D23, D24, D29, D30, D35, D36: 3A/40V/500mV; SMA-DIODE
E$1, E$2, E$3, E$4: FIDUCIAL-1X2
E$5, E$6: FIDUCIAL-1.5X3
FD1, FD2, FD3, FD4, FD5, FD6, FD7, FD8, FD9, FD10, FD11, FD12, FD13, FD14, FD15, FD16, FD17, FD18, FD19, FD20, FD21, FD22, FD23, FD24: FIDUCIAL1X2; FIDUCIAL-1X2
I2C_PU, I2C_PU1, I2C_PU2, I2C_PU3, I2C_PU4, I2C_PU5: JUMPER-SMT_3_2-NC_TRACE_SILK; SMT-JUMPER_3_2-NC_TRACE_SILK
IO1, IO2, IO3, IO4, IO5, IO6: JUMPER-SMT_2_NC_TRACE_SILK; SMT-JUMPER_2_NC_TRACE_SILK
J1, J4, J9, J13, J17, J21: QWIIC_RIGHT_ANGLE; JST04_1MM_RA
J2, J8, J12, J16, J20, J24: XBEE3-SMD
J3, J5, J6, J7, J10, J11, J14, J15, J18, J19, J22, J23: 1X10_NO_SILK
L1, L2, L3, L4, L5, L6: 3.9UH; INDUCTOR_3.9UH
LOGO1, LOGO6, LOGO9, LOGO12, LOGO15, LOGO18: SFE_LOGO_NAMEBLANK; BLANK
LOGO2, LOGO4, LOGO7, LOGO10, LOGO13, LOGO16: OSHW-LOGOS; OSHW-LOGO-S
LOGO3, LOGO5, LOGO8, LOGO11, LOGO14, LOGO17: QWIIC_LOGO_4MM; QWIIC_4MM
PLED, PLED1, PLED2, PLED3, PLED4, PLED5: JUMPER-SMT_2_NC_TRACE_SILK; SMT-JUMPER_2_NC_TRACE_SILK
Q1, Q2, Q4, Q10, Q11, Q12, Q16, Q17, Q18, Q22, Q23, Q24, Q28, Q29, Q30, Q34, Q35, Q36: 220mA/50V/3.5Ω; SOT23-3
Q3, Q9, Q15, Q21, Q27, Q33: 3.1A/30V/105mΩ; SOT23-3
Q5, Q6, Q13, Q19, Q25, Q31: 20V/4.2A/52mΩ/1.4W; SOT23-3
Q7, Q8, Q14, Q20, Q26, Q32: SOT363_PHILIPS
R1, R2, R4, R12, R13, R14, R15, R16, R19, R21, R28, R29, R31, R32, R34, R36, R43, R44, R46, R47, R49, R51, R58, R59, R61, R62, R64, R66, R73, R74, R76, R77, R79, R81, R88, R89: 2.2k; 0603
R3, R6, R9, R20, R24, R30, R35, R39, R45, R50, R54, R60, R65, R69, R75, R80, R84, R90: 100k; 0603
R5, R27, R42, R57, R72, R87: 10k; 0603
R7, R8, R22, R23, R37, R38, R52, R53, R67, R68, R82, R83: 5.1k; 0603
R10, R26, R41, R56, R71, R86: 330; 0603
R11, R18, R33, R48, R63, R78: 4.7k; 0603
R17, R25, R40, R55, R70, R85: 1M; 0603
RLED, RLED1, RLED2, RLED3, RLED4, RLED5: JUMPER-SMT_2_NC_TRACE_SILK; SMT-JUMPER_2_NC_TRACE_SILK
S1, S2, S3, S6, S9, S10, S13, S14, S17, S18, S21, S22: TACTILE_SWITCH_SMD_5.2MM
S4, S5, S7, S8, S11, S12, S15, S16, S19, S20, S23, S24: SWITCH_DPDT_SMD_AYZ0202
SHLD, SHLD1, SHLD2, SHLD3, SHLD4, SHLD5: JUMPER-SMT_2_NC_TRACE_SILK; SMT-JUMPER_2_NC_TRACE_SILK
U1, U2, U3, U4, U5, U6: AP63203; SOT23-6
U$1, U$146, U$242, U$338, U$434, U$530: RSSI31
U$2, U$147, U$243, U$339, U$435, U$531: PWR29
U$3, U$56, U$123, U$136, U$219, U$232, U$315, U$328, U$411, U$424, U$507, U$520: #SDA#10
U$4, U$130, U$226, U$322, U$418, U$514: #SHLD#36
U$5, U$9, U$131, U$135, U$227, U$231, U$323, U$327, U$419, U$423, U$515, U$519: #NC#1
U$6, U$103, U$199, U$295, U$391, U$487: #D3#AD3#23
U$7, U$10, U$132, U$133, U$228, U$229, U$324, U$325, U$420, U$421, U$516, U$517: #NC#3
U$8, U$155, U$251, U$347, U$443, U$539: ##DTR##27
U$11, U$101, U$197, U$293, U$389, U$485: #D1#AD1#8
U$12, U$156, U$252, U$348, U$444, U$540: ##CTS##28
U$13, U$109, U$205, U$301, U$397, U$493: #D8##DTR##27
U$14, U$110, U$206, U$302, U$398, U$494: #RSSI#D10#17
U$15, U$111, U$207, U$303, U$399, U$495: #SDA#D11#9
U$16, U$112, U$208, U$304, U$400, U$496: ##RST##15
U$17, U$113, U$209, U$305, U$401, U$497: #POCI#D12#24
U$18, U$114, U$210, U$306, U$402, U$498: #RXI#D14#15
U$19, U$102, U$198, U$294, U$390, U$486: #D2#AD2#19
U$20, U$104, U$200, U$296, U$392, U$488: #D6##RTS##25
U$21, U$32, U$118, U$139, U$214, U$235, U$310, U$331, U$406, U$427, U$502, U$523: #TXO#8
U$22, U$115, U$211, U$307, U$403, U$499: #TXO#D13#13
U$23, U$162, U$258, U$354, U$450, U$546: VIN5
U$24, U$137, U$233, U$329, U$425, U$521: #SCL#7
U$25, U$29, U$41, U$50, U$53, U$63, U$76, U$82, U$134, U$138, U$142, U$148, U$157, U$165, U$166, U$170, U$230, U$234, U$238, U$244, U$253, U$261, U$262, U$266, U$326, U$330, U$334, U$340, U$349, U$357, U$358, U$362, U$422, U$426, U$430, U$436, U$445, U$453, U$454, U$458, U$518, U$522, U$526, U$532, U$541, U$549, U$550, U$554: #GND#0
U$26, U$97, U$193, U$289, U$385, U$481: #I2C#33
U$27, U$33, U$119, U$140, U$215, U$236, U$311, U$332, U$407, U$428, U$503, U$524: #RXI#7
U$28, U$177, U$273, U$369, U$465, U$561: DRX52
U$30, U$99, U$195, U$291, U$387, U$483: #RST#30
U$31, U$163, U$259, U$355, U$451, U$547: #PICO#27
U$34, U$178, U$274, U$370, U$466, U$562: DTX53
U$35, U$105, U$201, U$297, U$393, U$489: #D5#ASSOC#25
U$36, U$106, U$202, U$298, U$394, U$490: #D9##SLP##28
U$37, U$107, U$203, U$299, U$395, U$491: #D7##CTS##26
U$38, U$108, U$204, U$300, U$396, U$492: #D4#PICO#25
U$39, U$66, U$154, U$167, U$250, U$263, U$346, U$359, U$442, U$455, U$538, U$551: #5V#5
U$40, U$98, U$194, U$290, U$386, U$482: D03
U$42, U$179, U$275, U$371, U$467, U$563: DLINE45
U$43, U$164, U$260, U$356, U$452, U$548: #X1#10
U$44, U$47, U$77, U$84, U$141, U$149, U$158, U$172, U$237, U$245, U$254, U$268, U$333, U$341, U$350, U$364, U$429, U$437, U$446, U$460, U$525, U$533, U$542, U$556: #3V3#1
U$45, U$120, U$216, U$312, U$408, U$504: #POCI#32
U$46, U$190, U$286, U$382, U$478, U$574: SHIELD55
U$48, U$180, U$276, U$372, U$468, U$564: UART44
U$49, U$116, U$212, U$308, U$404, U$500: #ALED#21
U$51, U$117, U$213, U$309, U$405, U$501: #RLED#22
U$52, U$159, U$255, U$351, U$447, U$543: #PLED#20
U$54, U$87, U$121, U$173, U$217, U$269, U$313, U$365, U$409, U$461, U$505, U$557: ##RST##13
U$55, U$122, U$218, U$314, U$410, U$506: #RSSI#16
U$57, U$124, U$220, U$316, U$412, U$508: #ASSOC#28
U$58, U$125, U$221, U$317, U$413, U$509: ##RTS##14
U$59, U$126, U$222, U$318, U$414, U$510: ##CS##26
U$60, U$127, U$223, U$319, U$415, U$511: #SCLK#33
U$61, U$100, U$196, U$292, U$388, U$484: SFE_LOGO_FLAME_.2
U$62, U$143, U$239, U$335, U$431, U$527: SFE_LOGO_NAME_.2
U$64, U$128, U$224, U$320, U$416, U$512: #SCL#9
U$65, U$129, U$225, U$321, U$417, U$513: #D0#3
U$67, U$168, U$264, U$360, U$456, U$552: #SDA#9
U$68, U$144, U$240, U$336, U$432, U$528: ##SLP##28
U$69, U$191, U$287, U$383, U$479, U$575: R3#R455
U$70, U$169, U$265, U$361, U$457, U$553: #SCL#13
U$71, U$86, U$181, U$185, U$277, U$281, U$373, U$377, U$469, U$473, U$565, U$569: #DRX#56
U$72, U$89, U$182, U$186, U$278, U$282, U$374, U$378, U$470, U$474, U$566, U$570: #DTX#57
U$73, U$183, U$279, U$375, U$471, U$567: #TXO#61
U$74, U$145, U$241, U$337, U$433, U$529: ASC32
U$75, U$176, U$272, U$368, U$464, U$560: POWER49
U$78, U$150, U$246, U$342, U$438, U$534: #D0#AD0#18
U$79, U$151, U$247, U$343, U$439, U$535: ARDUINO1345
U$80, U$152, U$248, U$344, U$440, U$536: XBEE340
U$81, U$153, U$249, U$345, U$441, U$537: SHIELD1346
U$83, U$171, U$267, U$363, U$459, U$555: #EN#15
U$85, U$184, U$280, U$376, U$472, U$568: #RXI#60
U$88, U$174, U$270, U$366, U$462, U$558: #VIN#4
U$90, U$187, U$283, U$379, U$475, U$571: #XBEE_DIO0#62
U$91, U$175, U$271, U$367, U$463, U$559: #UART#4048234
U$92, U$188, U$284, U$380, U$476, U$572: #XBEE_DIO9#62
U$93, U$160, U$256, U$352, U$448, U$544: #IOLED#5
U$94, U$161, U$257, U$353, U$449, U$545: IO49
U$95, U$189, U$285, U$381, U$477, U$573: SOURCE54
U$96, U$192, U$288, U$384, U$480, U$576: USB#C58
UART, UART1, UART2, UART3, UART4, UART5: USB Female Type C Connector; USB-C-16P-4LAYER-ISOLATED
X1, X2, X3, X4, X5, X6: JUMPER-SMT_2_NO_SILK; SMT-JUMPER_2_NO_SILK

Connections:
3.3V: C5.1, C7.1, C8.1, C9.1, C10.1, D7.C, I2C_PU.2, J2.1, J4.2, J6.1, Q5.2, Q7.4, R11.1
3.3V1: C16.1, C17.1, C18.1, C19.1, C20.1, D11.C, I2C_PU1.2, J1.2, J7.1, J8.1, Q6.2, Q8.4, R18.1
3.3V2: C26.1, C27.1, C28.1, C29.1, C30.1, D17.C, I2C_PU2.2, J9.2, J11.1, J12.1, Q13.2, Q14.4, R33.1
3.3V3: C36.1, C37.1, C38.1, C39.1, C40.1, D23.C, I2C_PU3.2, J13.2, J15.1, J16.1, Q19.2, Q20.4, R48.1
3.3V4: C46.1, C47.1, C48.1, C49.1, C50.1, D29.C, I2C_PU4.2, J17.2, J19.1, J20.1, Q25.2, Q26.4, R63.1
3.3V5: C56.1, C57.1, C58.1, C59.1, C60.1, D35.C, I2C_PU5.2, J21.2, J23.1, J24.1, Q31.2, Q32.4, R78.1
3.3V_R1: B2.3.3V, Q9.2, R27.2, R28.2, R29.2, S7.3, S7.6
3.3V_R2: B3.3.3V, Q15.2, R42.2, R43.2, R44.2, S11.3, S11.6
3.3V_R3: B1.3.3V, Q3.2, R1.2, R4.2, R5.2, S5.3, S5.6
3.3V_R4: B4.3.3V, Q21.2, R57.2, R58.2, R59.2, S15.3, S15.6
3.3V_R5: B5.3.3V, Q27.2, R72.2, R73.2, R74.2, S19.3, S19.6
3.3V_R6: B6.3.3V, Q33.2, R87.2, R88.2, R89.2, S23.3, S23.6
3.3V_VREG: C2.1, C4.1, L1.P$2, Q5.3, Q7.1, U2.1
3.3V_VREG1: C12.1, C13.1, L2.P$2, Q6.3, Q8.1, U1.1
3.3V_VREG2: C22.1, C23.1, L3.P$2, Q13.3, Q14.1, U3.1
3.3V_VREG3: C32.1, C33.1, L4.P$2, Q19.3, Q20.1, U4.1
3.3V_VREG4: C42.1, C43.1, L5.P$2, Q25.3, Q26.1, U5.1
3.3V_VREG5: C52.1, C53.1, L6.P$2, Q31.3, Q32.1, U6.1
5V: B1.5V, D9.C
5V1: B2.5V, D12.C
5V2: B3.5V, D18.C
5V3: B4.5V, D24.C
5V4: B5.5V, D30.C
5V5: B6.5V, D36.C
!RESET!: C6.1, J2.5, J6.5, S1.1, S1.2
!RESET!1: C15.1, J7.5, J8.5, S3.1, S3.2
!RESET!2: C25.1, J11.5, J12.5, S9.1, S9.2
!RESET!3: C35.1, J15.5, J16.5, S13.1, S13.2
!RESET!4: C45.1, J19.5, J20.5, S17.1, S17.2
!RESET!5: C55.1, J23.5, J24.5, S21.1, S21.2
D0: B1.D7, J2.20, J5.1, S2.1, S2.2
D1: B2.D7, J3.1, J8.20, S6.1, S6.2
D1/SCL: J2.19, J4.4, J5.2, Q4.2, R15.1
D1/SCL1: J1.4, J3.2, J8.19, Q12.2, R16.1
D1/SCL2: J9.4, J10.2, J12.19, Q18.2, R32.1
D1/SCL3: J13.4, J14.2, J16.19, Q24.2, R47.1
D1/SCL4: J17.4, J18.2, J20.19, Q30.2, R62.1
D1/SCL5: J21.4, J22.2, J24.19, Q36.2, R77.1
D2: B3.D7, J10.1, J12.20, S10.1, S10.2
D2/SPI_CLK: J2.18, J5.3
D2/SPI_CLK1: J3.3, J8.18
D2/SPI_CLK2: J10.3, J12.18
D2/SPI_CLK3: J14.3, J16.18
D2/SPI_CLK4: J18.3, J20.18
D2/SPI_CLK5: J22.3, J24.18
D3: B4.D7, J14.1, J16.20, S14.1, S14.2
D3/SPI_!CS!: J2.17, J5.4
D3/SPI_!CS!1: J3.4, J8.17
D3/SPI_!CS!2: J10.4, J12.17
D3/SPI_!CS!3: J14.4, J16.17
D3/SPI_!CS!4: J18.4, J20.17
D3/SPI_!CS!5: J22.4, J24.17
D4: B5.D7, J18.1, J20.20, S18.1, S18.2
D4/SPI_PICO: J2.11, J5.10, R10.1
D4/SPI_PICO1: J3.10, J8.11, R26.1
D4/SPI_PICO2: J10.10, J12.11, R41.1
D4/SPI_PICO3: J14.10, J16.11, R56.1
D4/SPI_PICO4: J18.10, J20.11, R71.1
D4/SPI_PICO5: J22.10, J24.11, R86.1
D5: B6.D7, J22.1, J24.20, S22.1, S22.2
D5/ASSOCIATE: J2.15, J5.6, R12.1
D5/ASSOCIATE1: J3.6, J8.15, R19.1
D5/ASSOCIATE2: J10.6, J12.15, R34.1
D5/ASSOCIATE3: J14.6, J16.15, R49.1
D5/ASSOCIATE4: J18.6, J20.15, R64.1
D5/ASSOCIATE5: J22.6, J24.15, R79.1
D6/!RTS!: J2.16, J5.5
D6/!RTS!1: J3.5, J8.16
D6/!RTS!2: J10.5, J12.16
D6/!RTS!3: J14.5, J16.16
D6/!RTS!4: J18.5, J20.16
D6/!RTS!5: J22.5, J24.16
D7/!CTS!: J2.12, J5.9
D7/!CTS!1: J3.9, J8.12
D7/!CTS!2: J10.9, J12.12
D7/!CTS!3: J14.9, J16.12
D7/!CTS!4: J18.9, J20.12
D7/!CTS!5: J22.9, J24.12
D8/!DTR!: J2.9, J6.9
D8/!DTR!1: J7.9, J8.9
D8/!DTR!2: J11.9, J12.9
D8/!DTR!3: J15.9, J16.9
D8/!DTR!4: J19.9, J20.9
D8/!DTR!5: J23.9, J24.9
D9/!SLEEP!: B1.D6, J2.13, J5.8
D9/!SLEEP!1: B2.D6, J3.8, J8.13
D9/!SLEEP!2: B3.D6, J10.8, J12.13
D9/!SLEEP!3: B4.D6, J14.8, J16.13
D9/!SLEEP!4: B5.D6, J18.8, J20.13
D9/!SLEEP!5: B6.D6, J22.8, J24.13
D10/RSSI_PWM: J2.6, J6.6, R2.1
D10/RSSI_PWM1: J7.6, J8.6, R21.1
D10/RSSI_PWM2: J11.6, J12.6, R36.1
D10/RSSI_PWM3: J15.6, J16.6, R51.1
D10/RSSI_PWM4: J19.6, J20.6, R66.1
D10/RSSI_PWM5: J23.6, J24.6, R81.1
D11/SDA: J2.7, J4.3, J6.7, Q2.2, R14.1
D11/SDA1: J1.3, J7.7, J8.7, Q11.2, R13.1
D11/SDA2: J9.3, J11.7, J12.7, Q17.2, R31.1
D11/SDA3: J13.3, J15.7, J16.7, Q23.2, R46.1
D11/SDA4: J17.3, J19.7, J20.7, Q29.2, R61.1
D11/SDA5: J21.3, J23.7, J24.7, Q35.2, R76.1
D12/SPI_POCI: J2.4, J6.4
D12/SPI_POCI1: J7.4, J8.4
D12/SPI_POCI2: J11.4, J12.4
D12/SPI_POCI3: J15.4, J16.4
D12/SPI_POCI4: J19.4, J20.4
D12/SPI_POCI5: J23.4, J24.4
D13/TXO: J2.2, J6.2, S4.2
D13/TXO1: J7.2, J8.2, S8.2
D13/TXO2: J11.2, J12.2, S12.2
D13/TXO3: J15.2, J16.2, S16.2
D13/TXO4: J19.2, J20.2, S20.2
D13/TXO5: J23.2, J24.2, S24.2
D13/TXO-R1: B2.RX, S8.3
D13/TXO-R2: B3.RX, S12.3
D13/TXO-R3: B1.RX, S4.3
D13/TXO-R4: B4.RX, S16.3
D13/TXO-R5: B5.RX, S20.3
D13/TXO-R6: B6.RX, S24.3
D14/RXI: J2.3, J6.3, S4.5
D14/RXI1: J7.3, J8.3, S8.5
D14/RXI2: J11.3, J12.3, S12.5
D14/RXI3: J15.3, J16.3, S16.5
D14/RXI4: J19.3, J20.3, S20.5
D14/RXI5: J23.3, J24.3, S24.5
D14/RXI-R1: B2.TX, S8.6
D14/RXI-R2: B3.TX, S12.6
D14/RXI-R3: B1.TX, S4.6
D14/RXI-R4: B4.TX, S16.6
D14/RXI-R5: B5.TX, S20.6
D14/RXI-R6: B6.TX, S24.6
D_RX: ARX.2, B1.D2
D_RX1: ARX1.2, B2.D2
D_RX2: ARX2.2, B3.D2
D_RX3: ARX3.2, B4.D2
D_RX4: ARX4.2, B5.D2
D_RX5: ARX5.2, B6.D2
D_RX_JUMP: ARX.1, S4.4
D_RX_JUMP1: ARX1.1, S8.4
D_RX_JUMP2: ARX2.1, S12.4
D_RX_JUMP3: ARX3.1, S16.4
D_RX_JUMP4: ARX4.1, S20.4
D_RX_JUMP5: ARX5.1, S24.4
D_TX: ATX.2, B1.D3
D_TX1: ATX1.2, B2.D3
D_TX2: ATX2.2, B3.D3
D_TX3: ATX3.2, B4.D3
D_TX4: ATX4.2, B5.D3
D_TX5: ATX5.2, B6.D3
D_TX_JUMP: ATX.1, S4.1
D_TX_JUMP1: ATX1.1, S8.1
D_TX_JUMP2: ATX2.1, S12.1
D_TX_JUMP3: ATX3.1, S16.1
D_TX_JUMP4: ATX4.1, S20.1
D_TX_JUMP5: ATX5.1, S24.1
EN: Q1.2, R3.1, U2.2
EN1: Q10.2, R20.1, U1.2
EN2: Q16.2, R35.1, U3.2
EN3: Q22.2, R50.1, U4.2
EN4: Q28.2, R65.1, U5.2
EN5: Q34.2, R80.1, U6.2
EN-TRANS: B1.D5, Q1.3, R5.1
EN-TRANS1: B2.D5, Q10.3, R27.1
EN-TRANS2: B3.D5, Q16.3, R42.1
EN-TRANS3: B4.D5, Q22.3, R57.1
EN-TRANS4: B5.D5, Q28.3, R72.1
EN-TRANS5: B6.D5, Q34.3, R87.1
GND: ALED.1, B1.GND@0, B1.GND@1, B1.GND@2, C1.2, C2.2, C4.2, C5.2, C6.2, C7.2, C8.2, C9.2, C10.2, IO4.1, J2.10, J4.1, J6.10, PLED.1, R6.1, R7.1, R8.1, R9.1, R17.1, RLED.1, S1.3, S1.4, S2.3, S2.4, S5.1, S5.4, SHLD.1, U2.4, UART.GND, UART.GND2
GND1: ALED1.1, B2.GND@0, B2.GND@1, B2.GND@2, C12.2, C13.2, C14.2, C15.2, C16.2, C17.2, C18.2, C19.2, C20.2, IO1.1, J1.1, J7.10, J8.10, PLED1.1, R22.1, R23.1, R24.1, R25.1, R30.1, RLED1.1, S3.3, S3.4, S6.3, S6.4, S7.1, S7.4, SHLD1.1, U1.4, UART1.GND, UART1.GND2
GND2: ALED2.1, B3.GND@0, B3.GND@1, B3.GND@2, C22.2, C23.2, C24.2, C25.2, C26.2, C27.2, C28.2, C29.2, C30.2, IO2.1, J9.1, J11.10, J12.10, PLED2.1, R37.1, R38.1, R39.1, R40.1, R45.1, RLED2.1, S9.3, S9.4, S10.3, S10.4, S11.1, S11.4, SHLD2.1, U3.4, UART2.GND, UART2.GND2
GND3: ALED3.1, B4.GND@0, B4.GND@1, B4.GND@2, C32.2, C33.2, C34.2, C35.2, C36.2, C37.2, C38.2, C39.2, C40.2, IO3.1, J13.1, J15.10, J16.10, PLED3.1, R52.1, R53.1, R54.1, R55.1, R60.1, RLED3.1, S13.3, S13.4, S14.3, S14.4, S15.1, S15.4, SHLD3.1, U4.4, UART3.GND, UART3.GND2
GND4: ALED4.1, B5.GND@0, B5.GND@1, B5.GND@2, C42.2, C43.2, C44.2, C45.2, C46.2, C47.2, C48.2, C49.2, C50.2, IO5.1, J17.1, J19.10, J20.10, PLED4.1, R67.1, R68.1, R69.1, R70.1, R75.1, RLED4.1, S17.3, S17.4, S18.3, S18.4, S19.1, S19.4, SHLD4.1, U5.4, UART4.GND, UART4.GND2
GND5: ALED5.1, B6.GND@0, B6.GND@1, B6.GND@2, C52.2, C53.2, C54.2, C55.2, C56.2, C57.2, C58.2, C59.2, C60.2, IO6.1, J21.1, J23.10, J24.10, PLED5.1, R82.1, R83.1, R84.1, R85.1, R90.1, RLED5.1, S21.3, S21.4, S22.3, S22.4, S23.1, S23.4, SHLD5.1, U6.4, UART5.GND, UART5.GND2
unnamed: C3.1, U2.6
unnamed: D4.A, R2.2
unnamed: D4.C, RLED.2
unnamed: D6.A, R10.2
unnamed: R8.2, UART.B5
unnamed: R7.2, UART.A5
unnamed: D2.A, R11.2
unnamed: C3.2, L1.P$1, U2.5
unnamed: D9.A, X1.2
unnamed: I2C_PU.1, Q4.1, R15.2
unnamed: I2C_PU.3, Q2.1, R14.2
unnamed: D3.A, R12.2
unnamed: I2C_PU1.3, Q11.1, R13.2
unnamed: D1.A, R18.2
unnamed: D5.A, R19.2
unnamed: D7.A, Q3.3, R9.2
unnamed: D6.C, IO4.2
unnamed: ALED1.2, D5.C
unnamed: Q7.2, Q7.5, Q7.6, R6.2
unnamed: Q5.1, Q7.3, R17.2
unnamed: ALED.2, D3.C
unnamed: D1.C, PLED1.2
unnamed: D2.C, PLED.2
unnamed: C11.1, U1.6
unnamed: C11.2, L2.P$1, U1.5
unnamed: D8.A, R21.2
unnamed: Q3.1, S5.2, S5.5
unnamed: D8.C, RLED1.2
unnamed: R23.2, UART1.B5
unnamed: R22.2, UART1.A5
unnamed: Q8.2, Q8.5, Q8.6, R24.2
unnamed: Q6.1, Q8.3, R25.2
unnamed: D10.A, R26.2
unnamed: D10.C, IO1.2
unnamed: Q9.1, S7.2, S7.5
unnamed: D11.A, Q9.3, R30.2
unnamed: D12.A, X2.2
unnamed: I2C_PU1.1, Q12.1, R16.2
unnamed: I2C_PU2.3, Q17.1, R31.2
unnamed: D13.A, R33.2
unnamed: D14.A, R34.2
unnamed: ALED2.2, D14.C
unnamed: D13.C, PLED2.2
unnamed: C21.1, U3.6
unnamed: C21.2, L3.P$1, U3.5
unnamed: D15.A, R36.2
unnamed: D15.C, RLED2.2
unnamed: R38.2, UART2.B5
unnamed: R37.2, UART2.A5
unnamed: Q14.2, Q14.5, Q14.6, R39.2
unnamed: Q13.1, Q14.3, R40.2
unnamed: D16.A, R41.2
unnamed: D16.C, IO2.2
unnamed: Q15.1, S11.2, S11.5
unnamed: D17.A, Q15.3, R45.2
unnamed: D18.A, X3.2
unnamed: I2C_PU2.1, Q18.1, R32.2
unnamed: I2C_PU3.3, Q23.1, R46.2
unnamed: D19.A, R48.2
unnamed: D20.A, R49.2
unnamed: ALED3.2, D20.C
unnamed: D19.C, PLED3.2
unnamed: C31.1, U4.6
unnamed: C31.2, L4.P$1, U4.5
unnamed: D21.A, R51.2
unnamed: D21.C, RLED3.2
unnamed: R53.2, UART3.B5
unnamed: R52.2, UART3.A5
unnamed: Q20.2, Q20.5, Q20.6, R54.2
unnamed: Q19.1, Q20.3, R55.2
unnamed: D22.A, R56.2
unnamed: D22.C, IO3.2
unnamed: Q21.1, S15.2, S15.5
unnamed: D23.A, Q21.3, R60.2
unnamed: D24.A, X4.2
unnamed: I2C_PU3.1, Q24.1, R47.2
unnamed: I2C_PU4.3, Q29.1, R61.2
unnamed: D25.A, R63.2
unnamed: D26.A, R64.2
unnamed: ALED4.2, D26.C
unnamed: D25.C, PLED4.2
unnamed: C41.1, U5.6
unnamed: C41.2, L5.P$1, U5.5
unnamed: D27.A, R66.2
unnamed: D27.C, RLED4.2
unnamed: R68.2, UART4.B5
unnamed: R67.2, UART4.A5
unnamed: Q26.2, Q26.5, Q26.6, R69.2
unnamed: Q25.1, Q26.3, R70.2
unnamed: D28.A, R71.2
unnamed: D28.C, IO5.2
unnamed: Q27.1, S19.2, S19.5
unnamed: D29.A, Q27.3, R75.2
unnamed: D30.A, X5.2
unnamed: I2C_PU4.1, Q30.1, R62.2
unnamed: I2C_PU5.3, Q35.1, R76.2
unnamed: D31.A, R78.2
unnamed: D32.A, R79.2
unnamed: ALED5.2, D32.C
unnamed: D31.C, PLED5.2
unnamed: C51.1, U6.6
unnamed: C51.2, L6.P$1, U6.5
unnamed: D33.A, R81.2
unnamed: D33.C, RLED5.2
unnamed: R83.2, UART5.B5
unnamed: R82.2, UART5.A5
unnamed: Q32.2, Q32.5, Q32.6, R84.2
unnamed: Q31.1, Q32.3, R85.2
unnamed: D34.A, R86.2
unnamed: D34.C, IO6.2
unnamed: Q33.1, S23.2, S23.5
unnamed: D35.A, Q33.3, R90.2
unnamed: D36.A, X6.2
unnamed: I2C_PU5.1, Q36.1, R77.2
R3_D1/SCL: B1.SCL, Q4.3, R4.1
R3_D1/SCL1: B2.SCL, Q12.3, R29.1
R3_D1/SCL2: B3.SCL, Q18.3, R44.1
R3_D1/SCL3: B4.SCL, Q24.3, R59.1
R3_D1/SCL4: B5.SCL, Q30.3, R74.1
R3_D1/SCL5: B6.SCL, Q36.3, R89.1
R3_D11/SDA: B1.SDA, Q2.3, R1.1
R3_D11/SDA1: B2.SDA, Q11.3, R28.1
R3_D11/SDA2: B3.SDA, Q17.3, R43.1
R3_D11/SDA3: B4.SDA, Q23.3, R58.1
R3_D11/SDA4: B5.SDA, Q29.3, R73.1
R3_D11/SDA5: B6.SDA, Q35.3, R88.1
SHLD: SHLD.2, UART.SHLD1, UART.SHLD2, UART.SHLD3, UART.SHLD4, UART.SHLD5, UART.SHLD6, UART.SHLD7, UART.SHLD8
SHLD1: SHLD1.2, UART1.SHLD1, UART1.SHLD2, UART1.SHLD3, UART1.SHLD4, UART1.SHLD5, UART1.SHLD6, UART1.SHLD7, UART1.SHLD8
SHLD2: SHLD2.2, UART2.SHLD1, UART2.SHLD2, UART2.SHLD3, UART2.SHLD4, UART2.SHLD5, UART2.SHLD6, UART2.SHLD7, UART2.SHLD8
SHLD3: SHLD3.2, UART3.SHLD1, UART3.SHLD2, UART3.SHLD3, UART3.SHLD4, UART3.SHLD5, UART3.SHLD6, UART3.SHLD7, UART3.SHLD8
SHLD4: SHLD4.2, UART4.SHLD1, UART4.SHLD2, UART4.SHLD3, UART4.SHLD4, UART4.SHLD5, UART4.SHLD6, UART4.SHLD7, UART4.SHLD8
SHLD5: SHLD5.2, UART5.SHLD1, UART5.SHLD2, UART5.SHLD3, UART5.SHLD4, UART5.SHLD5, UART5.SHLD6, UART5.SHLD7, UART5.SHLD8
V_USB: C1.1, Q1.1, R3.2, U2.3, UART.VBUS1, UART.VBUS2, X1.1
V_USB1: C14.1, Q10.1, R20.2, U1.3, UART1.VBUS1, UART1.VBUS2, X2.1
V_USB2: C24.1, Q16.1, R35.2, U3.3, UART2.VBUS1, UART2.VBUS2, X3.1
V_USB3: C34.1, Q22.1, R50.2, U4.3, UART3.VBUS1, UART3.VBUS2, X4.1
V_USB4: C44.1, Q28.1, R65.2, U5.3, UART4.VBUS1, UART4.VBUS2, X5.1
V_USB5: C54.1, Q34.1, R80.2, U6.3, UART5.VBUS1, UART5.VBUS2, X6.1
