sparkfun/SparkFun_Digi_XBee_Arduino_Shield-USB-C/(commit log)

2023-02-07 General placement of parts
    [SparkFun_XBee3_Cat1_Smart_Modem_USB-C.brd, SparkFun_XBee3_Cat1_Smart_Modem_USB-C.sch]
2023-02-07 More changes to part placement
    [SparkFun_XBee3_Cat1_Smart_Modem_USB-C.brd, SparkFun_XBee3_Cat1_Smart_Modem_USB-C.sch]
2023-02-08 Rearranges USB-C and Qwiic connectors
    [SparkFun_XBee3_Cat1_Smart_Modem_USB-C.brd, SparkFun_XBee3_Cat1_Smart_Modem_USB-C.sch]
2023-02-08 Routes some nets ( feels good now )
    [SparkFun_XBee3_Cat1_Smart_Modem_USB-C.brd]
2023-02-08 Routes more stuff
    [SparkFun_XBee3_Cat1_Smart_Modem_USB-C.brd, SparkFun_XBee3_Cat1_Smart_Modem_USB-C.sch]
2023-02-08 Routes stuff in a sloppy manner - getting rid of airwires
    [SparkFun_XBee3_Cat1_Smart_Modem_USB-C.brd]
2023-02-08 Routes air wires
    [SparkFun_XBee3_Cat1_Smart_Modem_USB-C.brd]
2023-02-09 Improves routing spaghetti
    [SparkFun_XBee3_Cat1_Smart_Modem_USB-C.brd]
2023-02-09 Updates many traces
    [SparkFun_XBee3_Cat1_Smart_Modem_USB-C.brd]
2023-02-09 Makes all drill sizes uniform (0.012")
    [SparkFun_XBee3_Cat1_Smart_Modem_USB-C.brd]
2023-02-09 Adds some silk
    [SparkFun_XBee3_Cat1_Smart_Modem_USB-C.brd]
2023-03-06 Adds FT231XS, pushes all signals to bottom layer that were on layer two
    * Adds decoupling cap and 100 Ohm resistor to UART MUX
    * Moves some silk around
    [SparkFun_XBee3_Cat1_Smart_Modem_USB-C.brd, SparkFun_XBee3_Cat1_Smart_Modem_USB-C.sch]
2023-03-06 More vias, improves routing
    [SparkFun_XBee3_Cat1_Smart_Modem_USB-C.brd]
2023-03-06 Renames board files
    [SparkFun_XBee_Arduino_Shield_Qwiic.brd, SparkFun_XBee_Arduino_Shield_Qwiic.sch]
2023-03-09 Routes all airwires, adds most silk labels
    [SparkFun_XBee_Arduino_Shield_Qwiic.brd, SparkFun_XBee_Arduino_Shield_Qwiic.sch]
2023-03-13 Adds all silk
    [SparkFun_XBee_Arduino_Shield_Qwiic.brd, SparkFun_XBee_Arduino_Shield_Qwiic.sch]
2023-03-13 Adds Measures
    [SparkFun_XBee_Arduino_Shield_Qwiic.brd]
2023-03-13 Puts the measures in the previous commit onto the measures layers
    [SparkFun_XBee_Arduino_Shield_Qwiic.brd]
2023-03-14 Arduino shield now with more level translators!
    [SparkFun_XBee_Arduino_Shield_Qwiic.brd, SparkFun_XBee_Arduino_Shield_Qwiic.sch]
2023-03-14 Adds silk in relevant places
    [SparkFun_XBee_Arduino_Shield_Qwiic.brd, SparkFun_XBee_Arduino_Shield_Qwiic.sch]
2023-03-14 Adds more stitching vias and silk labels
    [SparkFun_XBee_Arduino_Shield_Qwiic.brd]
2023-03-15 Adds decoupling caps to TXS0108E and attempts to fix the silk
    [SparkFun_XBee_Arduino_Shield_Qwiic.brd, SparkFun_XBee_Arduino_Shield_Qwiic.sch]
2023-03-15 Adds a few more labels
    [SparkFun_XBee_Arduino_Shield_Qwiic.brd, SparkFun_XBee_Arduino_Shield_Qwiic.sch]
2023-03-16 Fixes a number of silk issues
    * Decreases the length delta (haha) between Direct USB data lines
    * Adds some clarifying text to the USB connectors
    * Adds title to the USB Mux section
    * Adjusts a number of traces around for better ground pour
    * Moves resistors away from LEDs so that the parts are not so cramped
    [SparkFun_XBee_Arduino_Shield_Qwiic.brd, SparkFun_XBee_Arduino_Shield_Qwiic.sch]
2023-03-16 Fixes new wire stub DRC issues,
    [SparkFun_XBee_Arduino_Shield_Qwiic.brd]
2023-03-16 Adds "1, 2, 3, 4" to layers and special ordering instructions
    [SparkFun_XBee_Arduino_Shield_Qwiic.brd, SparkFun_XBee_Arduino_Shield_Qwiic.sch]
2023-03-16 Fixes wire stub DRC error
    [SparkFun_XBee_Arduino_Shield_Qwiic.brd, SparkFun_XBee_Arduino_Shield_Qwiic.sch]
2023-03-16 Adjusts two silk labels ever so slightly
    [SparkFun_XBee_Arduino_Shield_Qwiic.brd]
2023-03-16 Adds protos
    [SparkFun_XBee_Arduino_Shield_Qwiic.GBL, SparkFun_XBee_Arduino_Shield_Qwiic.GBO, SparkFun_XBee_Arduino_Shield_Qwiic.GBP, SparkFun_XBee_Arduino_Shield_Qwiic.GBS, SparkFun_XBee_Arduino_Shield_Qwiic.GKO, SparkFun_XBee_Arduino_Shield_Qwiic.GTL, SparkFun_XBee_Arduino_Shield_Qwiic.GTO, SparkFun_XBee_Arduino_Shield_Qwiic.GTP]
2023-04-06 Rolls to v02
    * Fixes USB data lines on main UART
    * Shifts ASC, RSSI nets to LEDs to be non-translated by default
    * Move SCL data line to non-translated by default
    [SparkFun_XBee_Arduino_Shield_Qwiic.brd, SparkFun_XBee_Arduino_Shield_Qwiic.sch]
2023-04-27 Adds new power control circuits
    [SparkFun_XBee_Arduino_Shield_Qwiic.brd, SparkFun_XBee_Arduino_Shield_Qwiic.sch]
2023-04-27 Routes most of the new air wires
    [SparkFun_XBee_Arduino_Shield_Qwiic.brd, SparkFun_XBee_Arduino_Shield_Qwiic.sch]
2023-05-01 Improvements to power selection
    * Routes airwires
    * Fixes some silk
    [SparkFun_XBee_Arduino_Shield_Qwiic.brd, SparkFun_XBee_Arduino_Shield_Qwiic.sch]
2023-05-01 Adds silk
    * Adds enable net, needs route
    [SparkFun_XBee_Arduino_Shield_Qwiic.brd, SparkFun_XBee_Arduino_Shield_Qwiic.sch]
2023-05-02 Routes enable pin
    [SparkFun_XBee_Arduino_Shield_Qwiic.brd, SparkFun_XBee_Arduino_Shield_Qwiic.sch]
2023-05-03 Replaces the PCHAN with a more suitable one
    * Routing improvements
    [SparkFun_XBee_Arduino_Shield_Qwiic.brd, SparkFun_XBee_Arduino_Shield_Qwiic.sch]
2023-05-03 Adds silk
    [SparkFun_XBee_Arduino_Shield_Qwiic.brd]
2023-05-03 Adds 10k between source and gate on PCHAN circuit
    * Switches two resistor values to 0402 so that everything can fit.
    [SparkFun_XBee_Arduino_Shield_Qwiic.brd, SparkFun_XBee_Arduino_Shield_Qwiic.sch]
2023-05-03 Adds more vias
    * Improves routing
    [SparkFun_XBee_Arduino_Shield_Qwiic.brd, SparkFun_XBee_Arduino_Shield_Qwiic.sch]
2023-05-04 Adds diode to high side switch, adds note to 10k resistor
    * Removes voltage divider between NCHAN mosfet and the gates of the PCHAN mosfets
    [SparkFun_XBee_Arduino_Shield_Qwiic.GBL, SparkFun_XBee_Arduino_Shield_Qwiic.GBO, SparkFun_XBee_Arduino_Shield_Qwiic.GBP, SparkFun_XBee_Arduino_Shield_Qwiic.GBS, SparkFun_XBee_Arduino_Shield_Qwiic.GKO, SparkFun_XBee_Arduino_Shield_Qwiic.GTL, SparkFun_XBee_Arduino_Shield_Qwiic.GTO, SparkFun_XBee_Arduino_Shield_Qwiic.GTP]
2023-05-18 Adds new switch
    [SparkFun_XBee_Arduino_Shield_Qwiic.brd, SparkFun_XBee_Arduino_Shield_Qwiic.sch]
2023-05-18 Adds some rough drafts
    [SparkFun_XBee_Arduino_Shield_Qwiic.brd, SparkFun_XBee_Arduino_Shield_Qwiic.sch]
2023-05-18 v03 changes
    * Replaces bi-directional power switch with jumper
    * Removes level translators
    * Removes a majority of nets connecting to R3 PTH
    [SparkFun_XBee_Arduino_Shield_Qwiic.brd, SparkFun_XBee_Arduino_Shield_Qwiic.sch]
2023-05-18 Optimizes traces
    [SparkFun_XBee_Arduino_Shield_Qwiic.brd, SparkFun_XBee_Arduino_Shield_Qwiic.sch]
2023-05-19 Improves spacing in schematic
    * Improves ground pour
    [SparkFun_XBee_Arduino_Shield_Qwiic.brd, SparkFun_XBee_Arduino_Shield_Qwiic.sch]
2023-05-19 Adds silk and vias
    [SparkFun_XBee_Arduino_Shield_Qwiic.brd, SparkFun_XBee_Arduino_Shield_Qwiic.sch]
2023-05-19 Adds more vias!!
    [SparkFun_XBee_Arduino_Shield_Qwiic.brd]
2023-05-19 Adds more measures and additional notes in the schematic
    [SparkFun_XBee_Arduino_Shield_Qwiic.brd, SparkFun_XBee_Arduino_Shield_Qwiic.sch]
2023-05-19 Adds more measures, vias, and notes
    * Rolls version to v10
    [SparkFun_XBee_Arduino_Shield_Qwiic.brd, SparkFun_XBee_Arduino_Shield_Qwiic.sch]
2023-05-19 Adds production panel, fixes acid trap
    [SparkFun_XBee_Arduino_Shield_Qwiic-Panel.brd, SparkFun_XBee_Arduino_Shield_Qwiic.brd]
2023-05-24 Adds Gerbers, updates ordering instructions to include material
    * Fixes "Off" and "On" silk on switch
    [SparkFun_XBee_Arduino_Shield_Qwiic-Panel.GBL, SparkFun_XBee_Arduino_Shield_Qwiic-Panel.GBO, SparkFun_XBee_Arduino_Shield_Qwiic-Panel.GBP, SparkFun_XBee_Arduino_Shield_Qwiic-Panel.GBS, SparkFun_XBee_Arduino_Shield_Qwiic-Panel.GKO, SparkFun_XBee_Arduino_Shield_Qwiic-Panel.GTL, SparkFun_XBee_Arduino_Shield_Qwiic-Panel.GTO, SparkFun_XBee_Arduino_Shield_Qwiic-Panel.GTP]
2023-05-24 Replaces old USB mux switch with new one
    * Removes 100Ohm resistor on VCC line
    [SparkFun_XBee_Arduino_Shield_Qwiic.brd, SparkFun_XBee_Arduino_Shield_Qwiic.sch]
2023-05-24 Small adjustment to design file after approving proximity DRC error
    * Remakes panels
    * Deletes old library
    [SparkFun_XBee_Arduino_Shield_Qwiic-Panel.brd, SparkFun_XBee_Arduino_Shield_Qwiic.brd, SparkFun_XBee_Arduino_Shield_Qwiic.sch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]
2023-07-10 Adds switch to UART lines for disconnect
    [SparkFun_XBee_Arduino_Shield_Qwiic.brd, SparkFun_XBee_Arduino_Shield_Qwiic.sch]
2023-07-14 Changes silk on switch and increments the version number
    [SparkFun_XBee_Arduino_Shield_Qwiic.brd, SparkFun_XBee_Arduino_Shield_Qwiic.sch]
2023-07-14 Adds new v11 panel
    [SparkFun_XBee_Arduino_Shield_Qwiic-Panel.brd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]
2023-09-18 Removes UART and direction communication
    [SparkFun_XBee_Arduino_Shield_Qwiic.brd, SparkFun_XBee_Arduino_Shield_Qwiic.sch]
2023-09-20 Moves USB-C to center of board
    [SparkFun_XBee_Arduino_Shield_Qwiic.brd]
2023-09-20 Reroutes switch
    [SparkFun_XBee_Arduino_Shield_Qwiic.brd, SparkFun_XBee_Arduino_Shield_Qwiic.sch]
2023-10-09 Adds jumpers for alternate serial pins, removes some text from schematic, moves power LED closer to USB-C
    [SparkFun_XBee_Arduino_Shield_Qwiic.brd, SparkFun_XBee_Arduino_Shield_Qwiic.sch]
2023-10-09 Cleans up some more schematic elements
    [SparkFun_XBee_Arduino_Shield_Qwiic.sch]
2023-10-10 Reconnects I2c lines, deletes old nets, removes diode from VUSB to VCC
    [SparkFun_XBee_Arduino_Shield_Qwiic.brd, SparkFun_XBee_Arduino_Shield_Qwiic.sch]
2023-10-12 Power fixes
    * Adds power isolation translation on I2C data lines using NCHAN mosfets
    * Moves the pullup on the VREG "EN" pin to use R3/R4 power rail - "3v3_SW"
    * Adds 100k to drain of PCHAN mosfet that sits between the 3v3 rail of R3/R4 line and 3v3 on the shield - this removes parasitic voltage from 3v3 rail when MOSFET was turn off.
    * Moves power destination of "Power Jumper" section from "VIN" to the "5V" rail of R3/R4
    * Updates silk
    * Changes any "alt_rx/tx" net names to be "drx/dtx"
    [SparkFun_XBee_Arduino_Shield_Qwiic.brd, SparkFun_XBee_Arduino_Shield_Qwiic.sch]
2023-10-13 Fixes power net names and mirrors translation mosfets
    * Changes 3v3_SW to 3v3_R3 to be more clear about the actual power source
    * Changes VCC to VUSB to also be more clear as to the source
    * Mirrors the source and drain on all translation mosfets so that that body diode is not biasing the 3v3 rail on the shield
    [SparkFun_XBee_Arduino_Shield_Qwiic.brd, SparkFun_XBee_Arduino_Shield_Qwiic.sch]
2023-10-13 Moves USBC circuit up a smidgen in the schematic
    [SparkFun_XBee_Arduino_Shield_Qwiic.sch]
2023-10-13 Minor changes to schematic elements
    [SparkFun_XBee_Arduino_Shield_Qwiic.brd, SparkFun_XBee_Arduino_Shield_Qwiic.sch]
2023-10-13 Updates schematic elements again , Adds USB-C to silk
    [SparkFun_XBee_Arduino_Shield_Qwiic.brd, SparkFun_XBee_Arduino_Shield_Qwiic.sch]
2023-10-13 Adds new production file for v12
    [SparkFun_XBee_Arduino_Shield_Qwiic-Panel.GBL, SparkFun_XBee_Arduino_Shield_Qwiic-Panel.GBO, SparkFun_XBee_Arduino_Shield_Qwiic-Panel.GBS, SparkFun_XBee_Arduino_Shield_Qwiic-Panel.GKO, SparkFun_XBee_Arduino_Shield_Qwiic-Panel.GTL, SparkFun_XBee_Arduino_Shield_Qwiic-Panel.GTO, SparkFun_XBee_Arduino_Shield_Qwiic-Panel.GTP, SparkFun_XBee_Arduino_Shield_Qwiic-Panel.GTS]
2023-10-13 Removes old prototypes
    [SparkFun_XBee_Arduino_Shield_Qwiic.GBL, SparkFun_XBee_Arduino_Shield_Qwiic.GBO, SparkFun_XBee_Arduino_Shield_Qwiic.GBP, SparkFun_XBee_Arduino_Shield_Qwiic.GBS, SparkFun_XBee_Arduino_Shield_Qwiic.GKO, SparkFun_XBee_Arduino_Shield_Qwiic.GTL, SparkFun_XBee_Arduino_Shield_Qwiic.GTO, SparkFun_XBee_Arduino_Shield_Qwiic.GTP]
2024-01-02 Updating UART Select Switch description
2024-01-03 Updating Hardware overview and assembly
2024-01-05 Updates to naming per Digi
    [SparkFun_Digi_XBee_Arduino_Shield_Qwiic.brd, SparkFun_Digi_XBee_Arduino_Shield_Qwiic.sch]
